ruibartsegura/ESP-Micro_drone/img/pcb_big.png

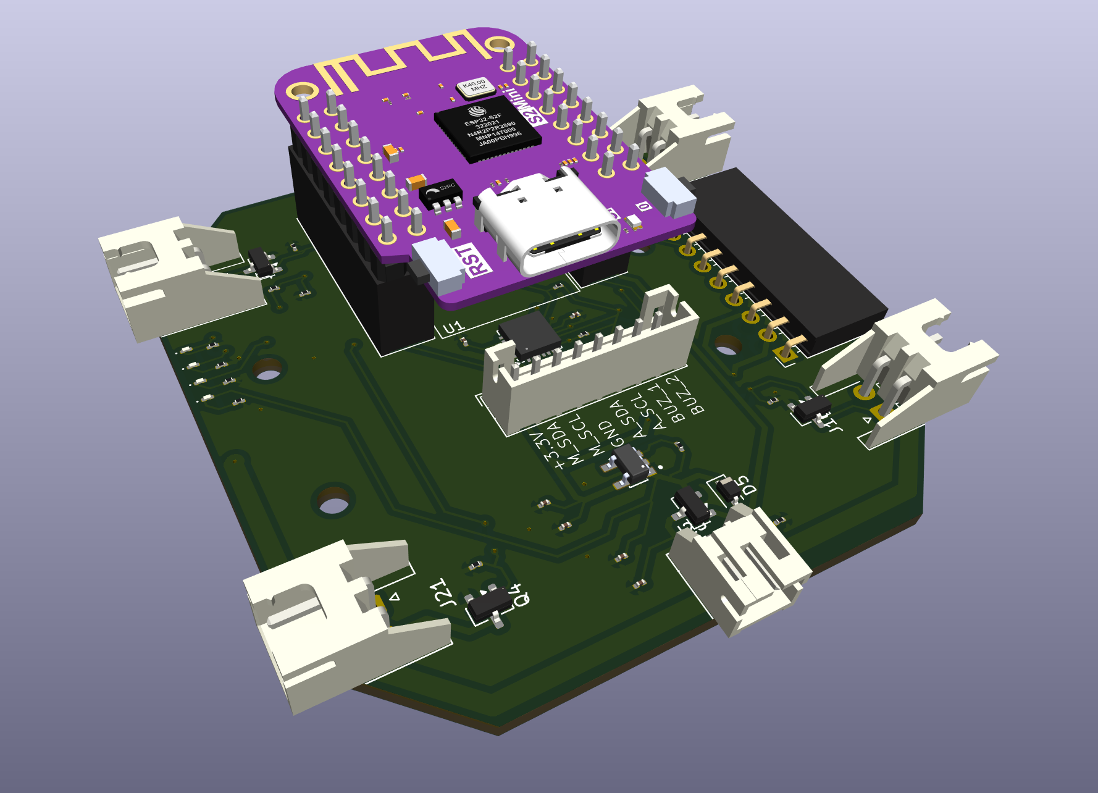
img/pcb_big.png
