ruibartsegura/ESP-Micro_drone/img/pcb_mini.png

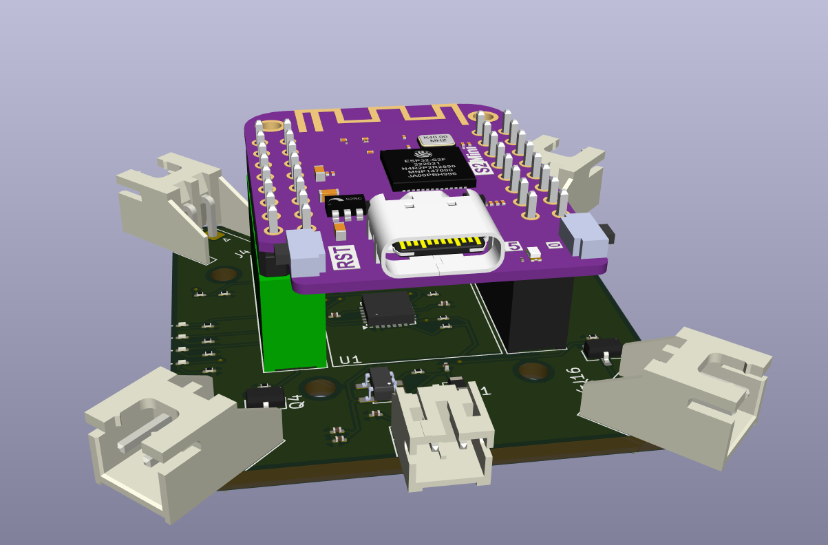
img/pcb_mini.png
