ruibartsegura/ESP-Micro_drone/img/pcb_smt.png

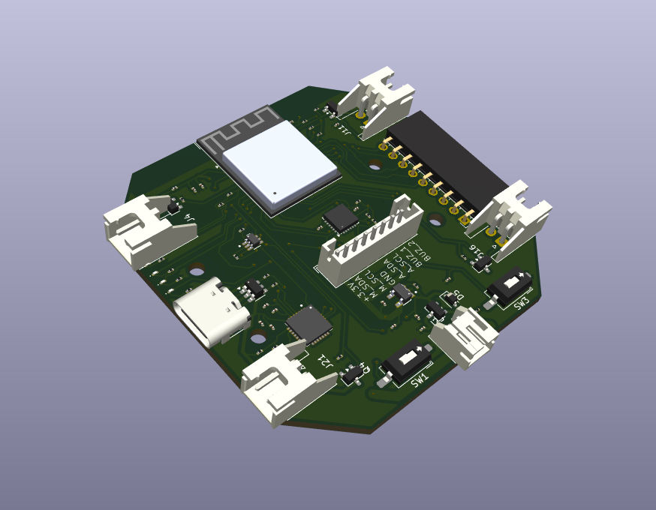
img/pcb_smt.png
