ruibartsegura/ESP-Micro_drone/Hardware_Design/Drone_Complete/motor_revol.FCStd

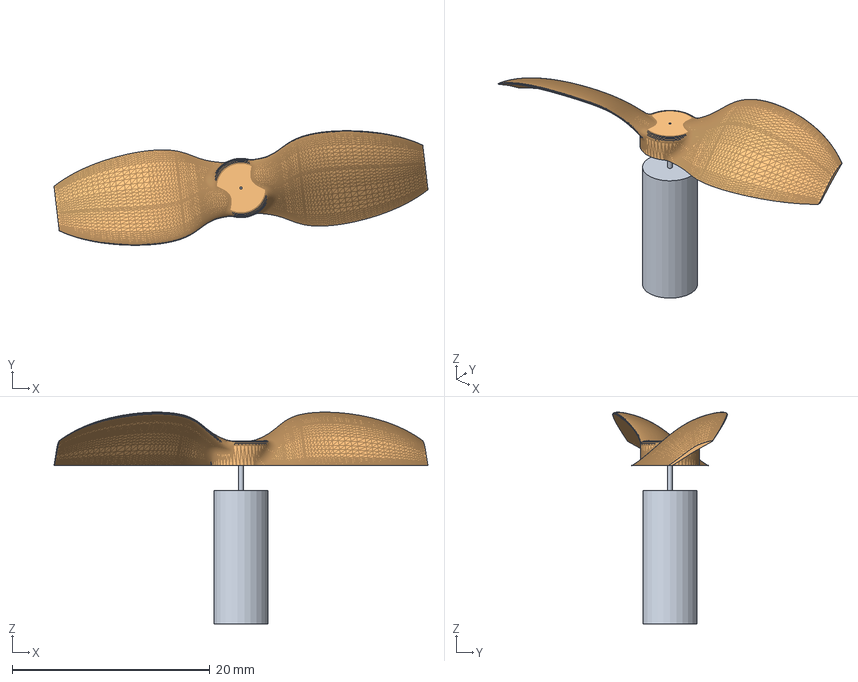
[picture p5: CAD file, 2026-03-26]
Hardware_Design/Drone_Complete/motor_revol.FCStd
37.8 x 11.6 x 21.4 mm
Scale
