ruibartsegura/ESP-Micro_drone/PCB_design/ESP_plug_mini_PCB_gy87/drone/production/drone.step

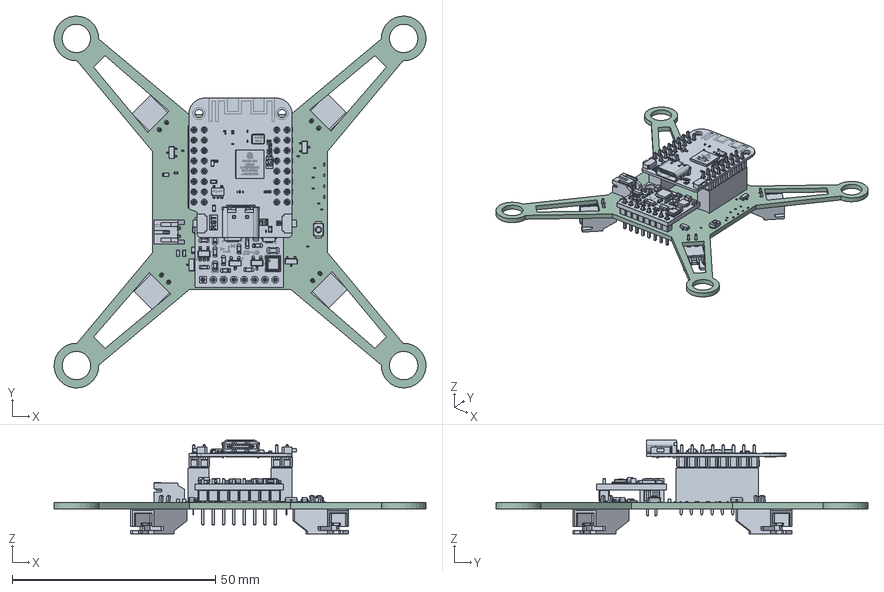
[picture p6: CAD file, 2026-09-25]
PCB_design/ESP_plug_mini_PCB_gy87/drone/production/drone.step
91.4 x 91.4 x 23.1 mm
C_0603_1608Metric x 9
LED_0201_0603Metric x 4
SOT-23 x 6
R_0201_0603Metric x 9
R_0402_1005Metric
SW_SPST_B3U-1000P
C_0201_0603Metric
USB_type_C_smd_12p v1
Pads
Pads2
Pads3
Pads4
Top Text
Bottom Text
Light
Anode Bottom
Cathode Bottom
Anode
Cathode
Base
40.00 MHz Oscillator v1
ESP32-S2 v3
ME6211-SOT23 v1
R01005 v2 x 6
uController Reset Button v1 x 2
pin x 32
D_SOD-323
R_0603_1608Metric x 8
JST_PH_S2B-PH-K_1x02_P2.00mm_Horizontal
PinSocket_2x08_P2.54mm_Vertical x 2
QFN-24-1EP_4x4mm_P0.5mm_EP2.7x2.7mm
SOT-23-5
LED_0603_1608Metric
BMP180
QFN-16-1EP_3x3mm_P0.5mm_EP1.7x1.7mm
CP_EIA-1608-10_AVX-L
C_0805_2012Metric x 4
PinHeader_1x08_P2.54mm_Vertical
GY87_10DOF_IMU_pad
GY87_10DOF_IMU_silkscreen
GY87_10DOF_IMU_soldermask
GY87_10DOF_IMU_PCB
JST_XH_S2B-XH-A-1_1x02_P2.50mm_Horizontal x 4
drone_PCB
