ruibartsegura/ESP-Micro_drone/Hardware_Design/Drone_Complete/pcb.FCStd

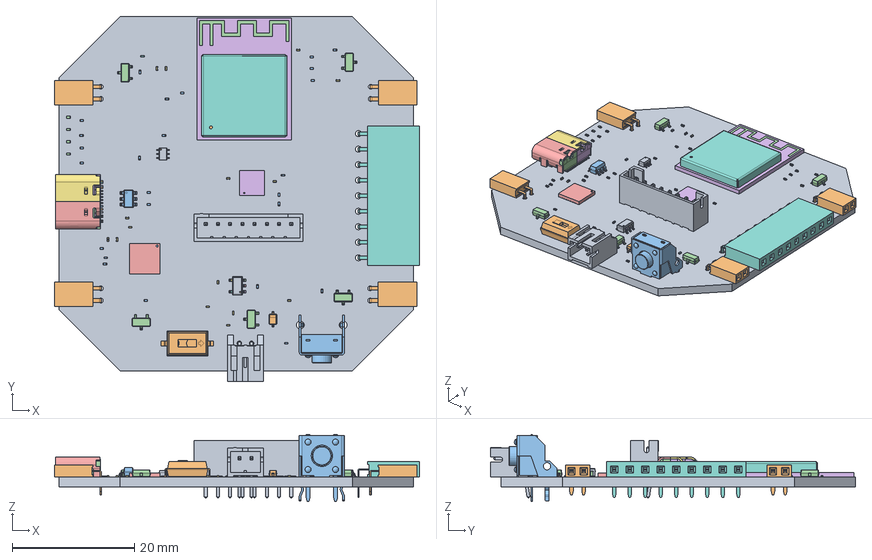
[picture p8: CAD file, 2026-03-26]
Hardware_Design/Drone_Complete/pcb.FCStd
59.8 x 59.8 x 11.0 mm
Pcb_9cbb
J21_PinSocket_1x02_P2.00mm_Horizontal_78d1e54ad34e x 4
R14_R_0201_0603Metric_42a1c245250d x 25
D7_LED_0201_0603Metric_9e26893dd0f0 x 4
CP2102N-A01-GQFN28
CP2102N-A01-GQFN029
CP2102N-A01-GQFN030
CP2102N-A01-GQFN031
CP2102N-A01-GQFN032
CP2102N-A01-GQFN033
CP2102N-A01-GQFN034
CP2102N-A01-GQFN035
CP2102N-A01-GQFN036
CP2102N-A01-GQFN037
CP2102N-A01-GQFN038
CP2102N-A01-GQFN039
CP2102N-A01-GQFN040
CP2102N-A01-GQFN041
CP2102N-A01-GQFN042
CP2102N-A01-GQFN043
CP2102N-A01-GQFN044
CP2102N-A01-GQFN045
CP2102N-A01-GQFN046
CP2102N-A01-GQFN047
CP2102N-A01-GQFN048
CP2102N-A01-GQFN049
CP2102N-A01-GQFN050
CP2102N-A01-GQFN051
CP2102N-A01-GQFN052
CP2102N-A01-GQFN053
CP2102N-A01-GQFN054
CP2102N-A01-GQFN055
CP2102N-A01-GQFN056
CP2102N-A01-GQFN057
CP2102N-A01-GQFN058
USB_C_Receptacle_16P_TopMnt_Horizontal_GCT_USB4105-xx-A
USB_C_Receptacle_16P_TopMnt_Horizontal_GCT_USB4105-xx-A001
USB_C_Receptacle_16P_TopMnt_Horizontal_GCT_USB4105-xx-A002
USB_C_Receptacle_16P_TopMnt_Horizontal_GCT_USB4105-xx-A003
USB_C_Receptacle_16P_TopMnt_Horizontal_GCT_USB4105-xx-A004
USB_C_Receptacle_16P_TopMnt_Horizontal_GCT_USB4105-xx-A005
USB_C_Receptacle_16P_TopMnt_Horizontal_GCT_USB4105-xx-A006
USB_C_Receptacle_16P_TopMnt_Horizontal_GCT_USB4105-xx-A007
USB_C_Receptacle_16P_TopMnt_Horizontal_GCT_USB4105-xx-A008
USB_C_Receptacle_16P_TopMnt_Horizontal_GCT_USB4105-xx-A009
USB_C_Receptacle_16P_TopMnt_Horizontal_GCT_USB4105-xx-A010
USB_C_Receptacle_16P_TopMnt_Horizontal_GCT_USB4105-xx-A011
USB_C_Receptacle_16P_TopMnt_Horizontal_GCT_USB4105-xx-A012
USB_C_Receptacle_16P_TopMnt_Horizontal_GCT_USB4105-xx-A013
USB_C_Receptacle_16P_TopMnt_Horizontal_GCT_USB4105-xx-A014
USB_C_Receptacle_16P_TopMnt_Horizontal_GCT_USB4105-xx-A015
USB_C_Receptacle_16P_TopMnt_Horizontal_GCT_USB4105-xx-A016
USB_C_Receptacle_16P_TopMnt_Horizontal_GCT_USB4105-xx-A017
USB_C_Receptacle_16P_TopMnt_Horizontal_GCT_USB4105-xx-A018
USB_C_Receptacle_16P_TopMnt_Horizontal_GCT_USB4105-xx-A019
USB_C_Receptacle_16P_TopMnt_Horizontal_GCT_USB4105-xx-A020
USB_C_Receptacle_16P_TopMnt_Horizontal_GCT_USB4105-xx-A021
USB_C_Receptacle_16P_TopMnt_Horizontal_GCT_USB4105-xx-A022
USB_C_Receptacle_16P_TopMnt_Horizontal_GCT_USB4105-xx-A023
USB_C_Receptacle_16P_TopMnt_Horizontal_GCT_USB4105-xx-A024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
