ruibartsegura/ESP-Micro_drone/PCB_design/extra_step_files/Wemos S2 Mini V1.0.0.step

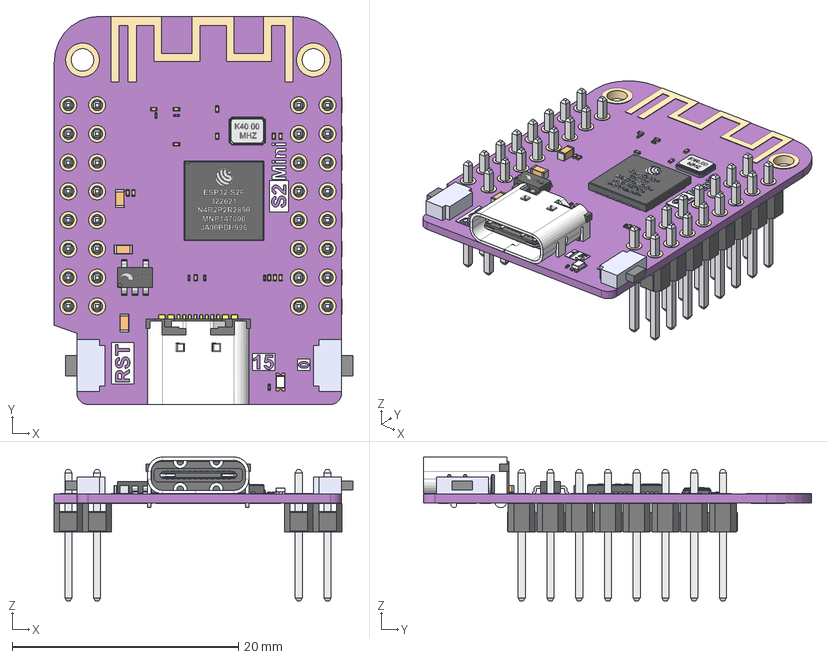
[picture p9: CAD file, 2026-09-25]
PCB_design/extra_step_files/Wemos S2 Mini V1.0.0.step
26.4 x 34.3 x 12.7 mm
USB_type_C_smd_12p
Pads
Pads2
Pads3
Pads4
Top Text
Bottom Text
Light
Anode Bottom
Cathode Bottom
Anode
Cathode
Base
40.00 MHz Oscillator
ESP32-S2
ME6211-SOT23
R01005 x 6
uController Reset Button x 2
pin x 32
