ruibartsegura/ESP-Micro_drone/Hardware_Design/Drone_Complete/motor_revol_esp.FCStd

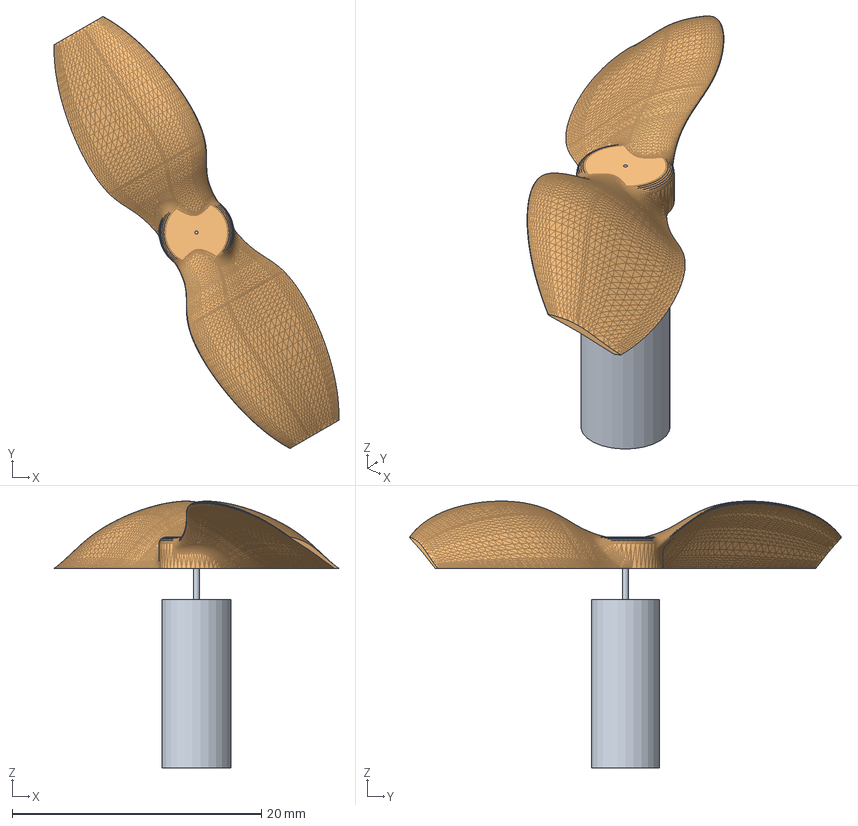
[picture p10: CAD file, 2026-03-26]
Hardware_Design/Drone_Complete/motor_revol_esp.FCStd
22.8 x 34.6 x 21.4 mm
Scale (reflejado)
