ruibartsegura/ESP-Micro_drone/Hardware_Design/Drone_Complete/Motor.FCStd

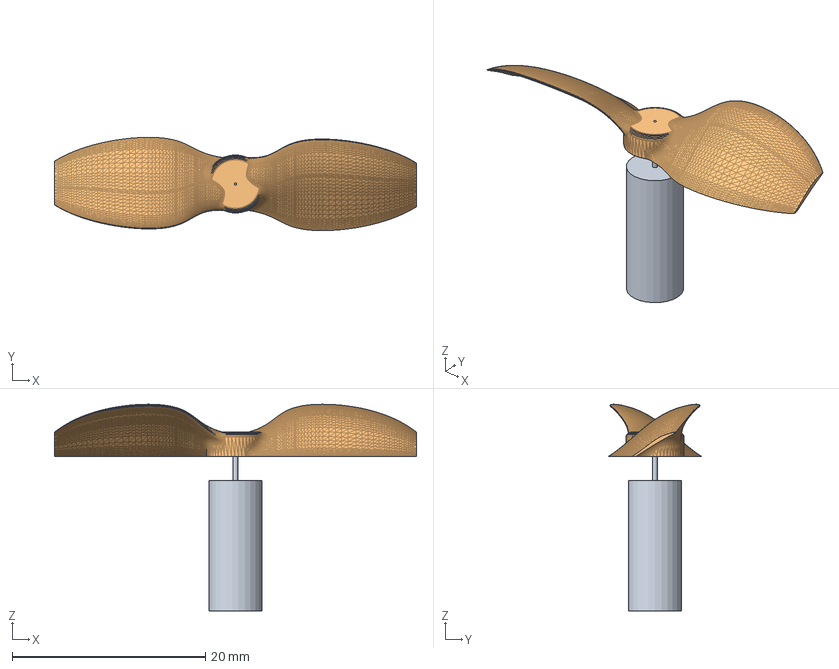
[picture p11: CAD file, 2026-03-26]
Hardware_Design/Drone_Complete/Motor.FCStd
37.5 x 9.66 x 21.4 mm
Scale
