ruibartsegura/ESP-Micro_drone/PCB_design/ESP_plug_mini_PCB_gy87/drone/drone.kicad_pcb

## KiCad design PCB_design/ESP_plug_mini_PCB_gy87/drone/drone.kicad_pcb (2026-09-25)

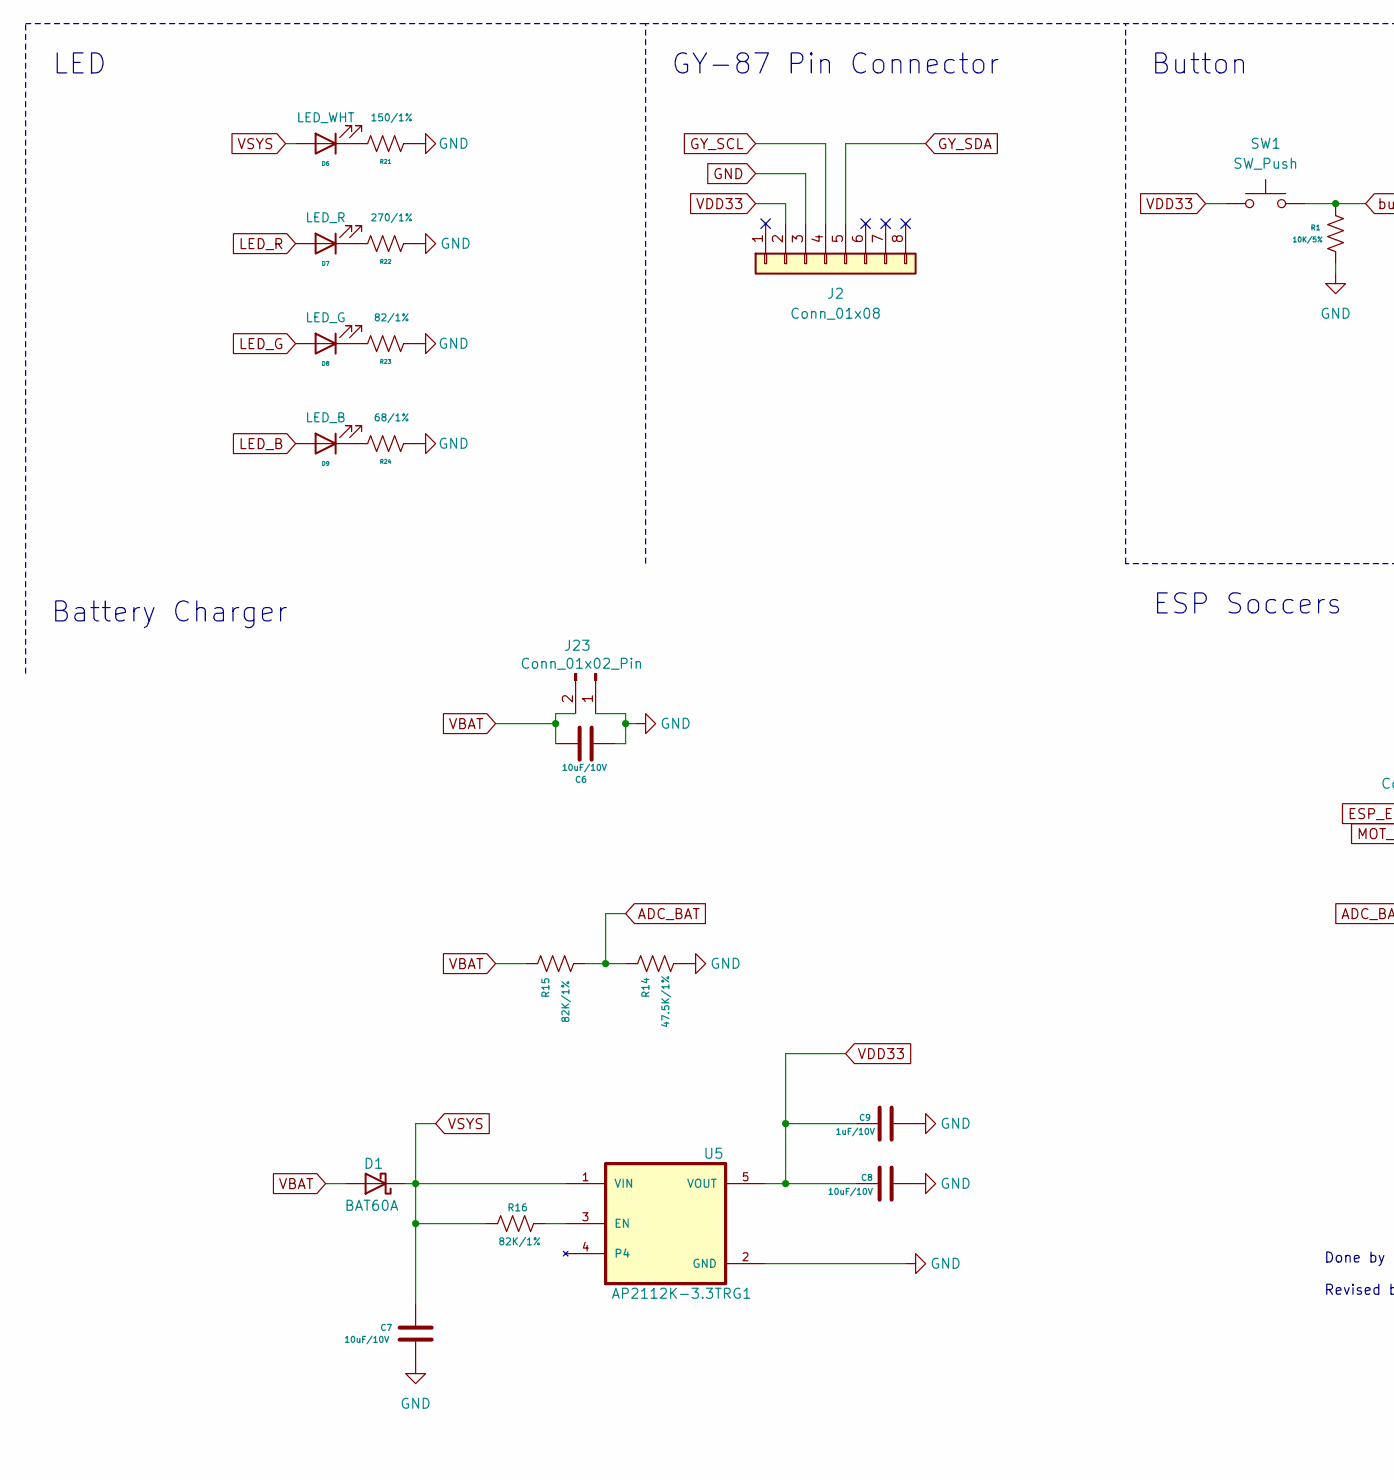
[picture p12: schematic drone.kicad_sch, part in row 1, column 1]

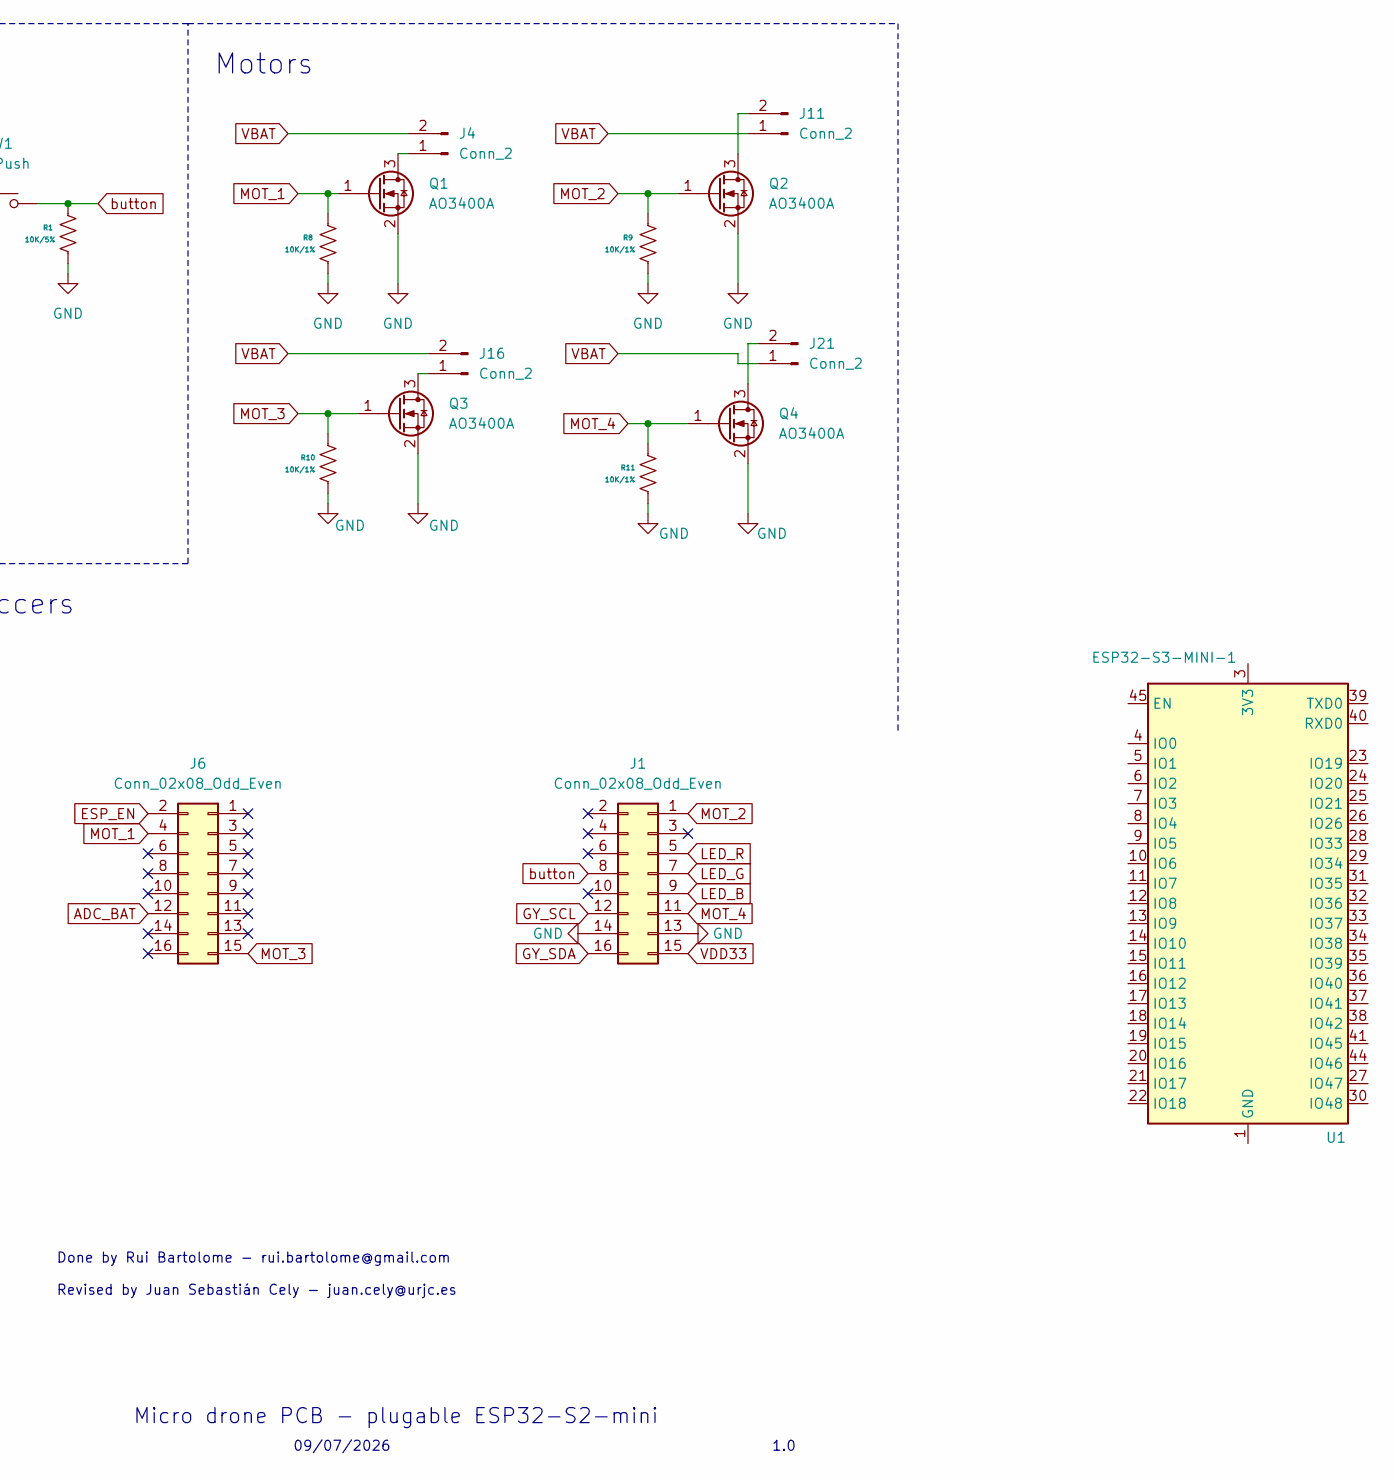
[picture p13: schematic drone.kicad_sch, part in row 1, column 2]

Parts:
C6, C7, C8: 10uF/10V; C_0603_1608Metric
C9: 1uF/10V; C_0201_0603Metric
D1: BAT60A; D_SOD-323
D6: LED_WHT; LED_0201_0603Metric
D7: LED_R; LED_0201_0603Metric
D8: LED_G; LED_0201_0603Metric
D9: LED_B; LED_0201_0603Metric
J1, J6: Conn_02x08_Odd_Even; PinSocket_2x08_P2.54mm_Vertical
J2: Conn_01x08; PinHeader_1x08_P2.54mm_Vertical
J4, J11, J16, J21: Conn_2; JST_XH_S2B-XH-A-1_1x02_P2.50mm_Horizontal
J23: Conn_01x02_Pin; JST_PH_S2B-PH-K_1x02_P2.00mm_Horizontal
Q1, Q2, Q3, Q4: AO3400A; SOT-23
R1: 10K/5%; R_0201_0603Metric
R8, R9, R10, R11: 10K/1%; R_0201_0603Metric
R14: 47.5K/1%; R_0402_1005Metric
R15, R16: 82K/1%; R_0603_1608Metric
R21: 150/1%; R_0201_0603Metric
R22: 270/1%; R_0201_0603Metric
R23: 82/1%; R_0201_0603Metric
R24: 68/1%; R_0201_0603Metric
SW1: SW_Push; SW_SPST_B3U-1000P
U1: ESP32-S3-MINI-1
U5: AP2112K-3.3TRG1; PARTREV 2-2

Connections:
ADC_BAT: J6.12, R14.2, R15.1
ESP_EN: J6.2
GND: C6.1, C7.1, C8.1, C9.1, J1.13, J1.14, J2.3, J23.1, Q1.2 (S), Q2.2 (S), Q3.2 (S), Q4.2 (S), R1.2, R8.2, R9.2, R10.2, R11.2, R14.1, R21.1, R22.1, R23.1, R24.1, U5.2 (GND)
GY_SCL: J1.12, J2.4
GY_SDA: J1.16, J2.5
LED_B: D9.2 (A), J1.9
LED_G: D8.2 (A), J1.7
LED_R: D7.2 (A), J1.5
MOT_1: J6.4, Q1.1 (G), R8.1
MOT_2: J1.1, Q2.1 (G), R9.1
MOT_3: J6.15, Q3.1 (G), R10.1
MOT_4: J1.11, Q4.1 (G), R11.1
unnamed: D6.1 (K), R21.2
unnamed: D7.1 (K), R22.2
unnamed: D8.1 (K), R23.2
unnamed: D9.1 (K), R24.2
unnamed: J4.1, Q1.3 (D)
unnamed: J11.2, Q2.3 (D)
unnamed: J16.1, Q3.3 (D)
unnamed: J21.2, Q4.3 (D)
unnamed: R16.2, U5.3 (EN)
VBAT: C6.2, D1.2 (A), J4.2, J11.1, J16.2, J21.1, J23.2, R15.2
VDD33: C8.2, C9.2, J1.15, J2.2, SW1.1, U5.5 (VOUT)
VSYS: C7.2, D1.1 (K), D6.2 (A), R16.1, U5.1 (VIN)
button: J1.8, R1.1, SW1.2

Notes on the sheet:
Button
Micro drone PCB - plugable ESP32-S2-mini
Battery Charger
GY-87 Pin Connector
Done by Rui Bartolome - rui.bartolome@gmail.com Revised by Juan Sebastián Cely - juan.cely@urjc.es
LED
1.0
09/07/2026
Motors
ESP Soccers

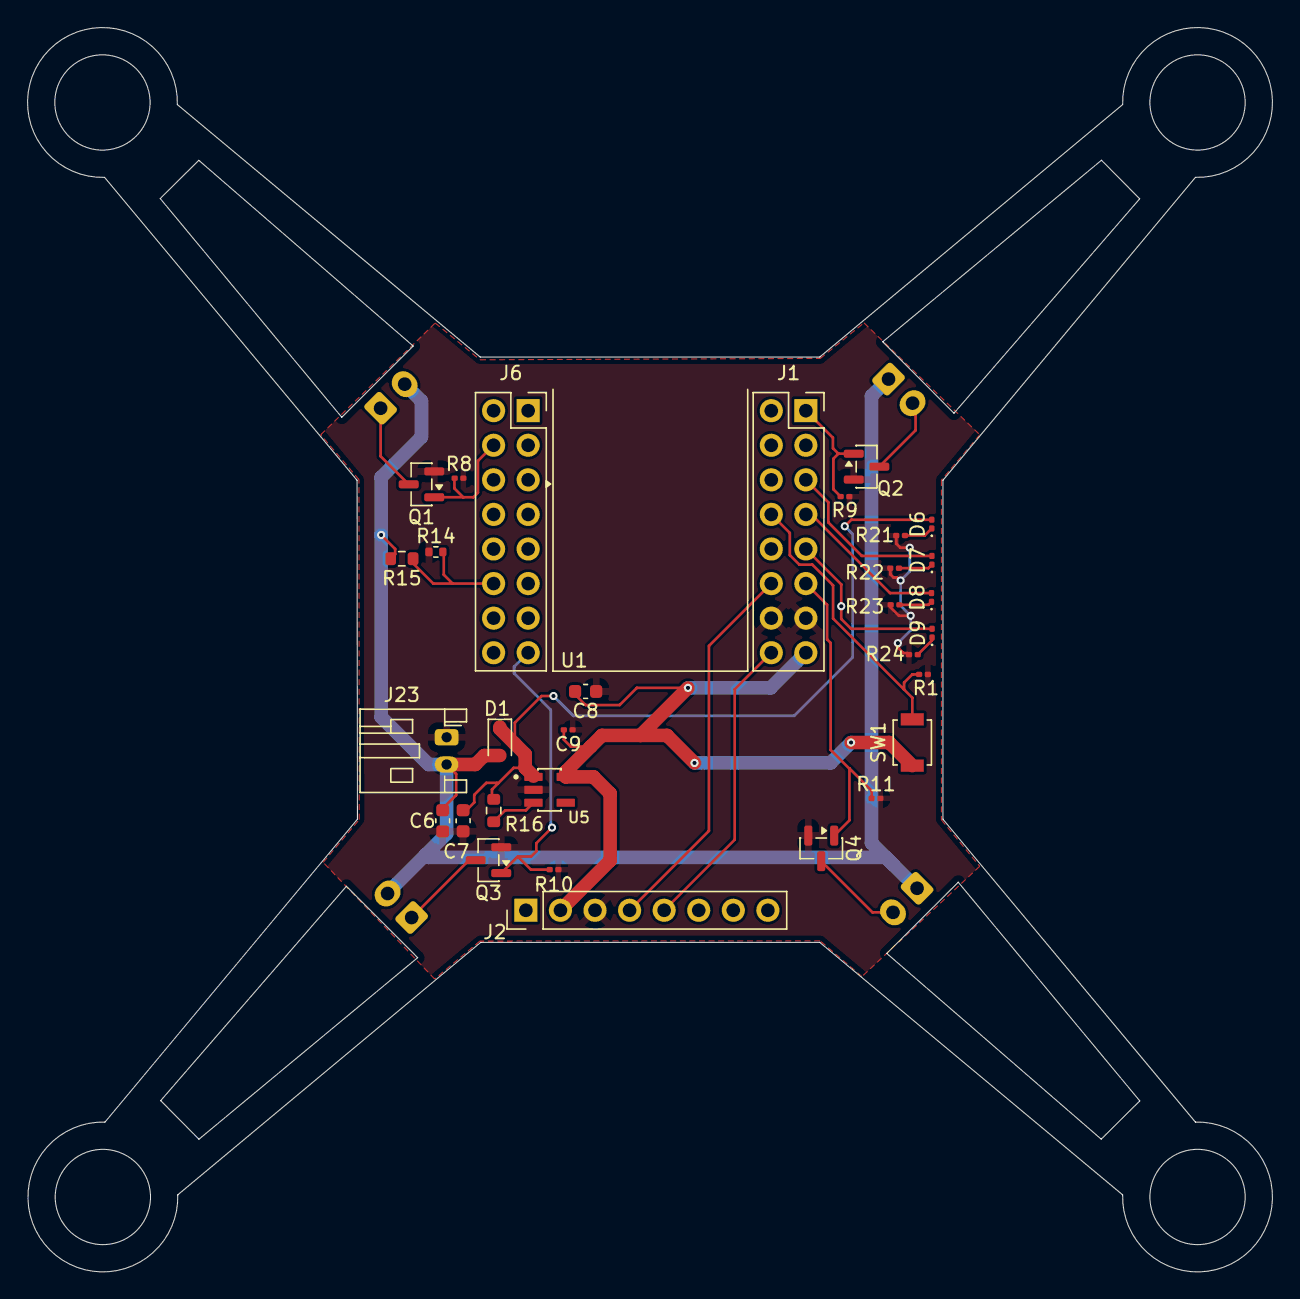
[picture p14: board drone.kicad_pcb from above]

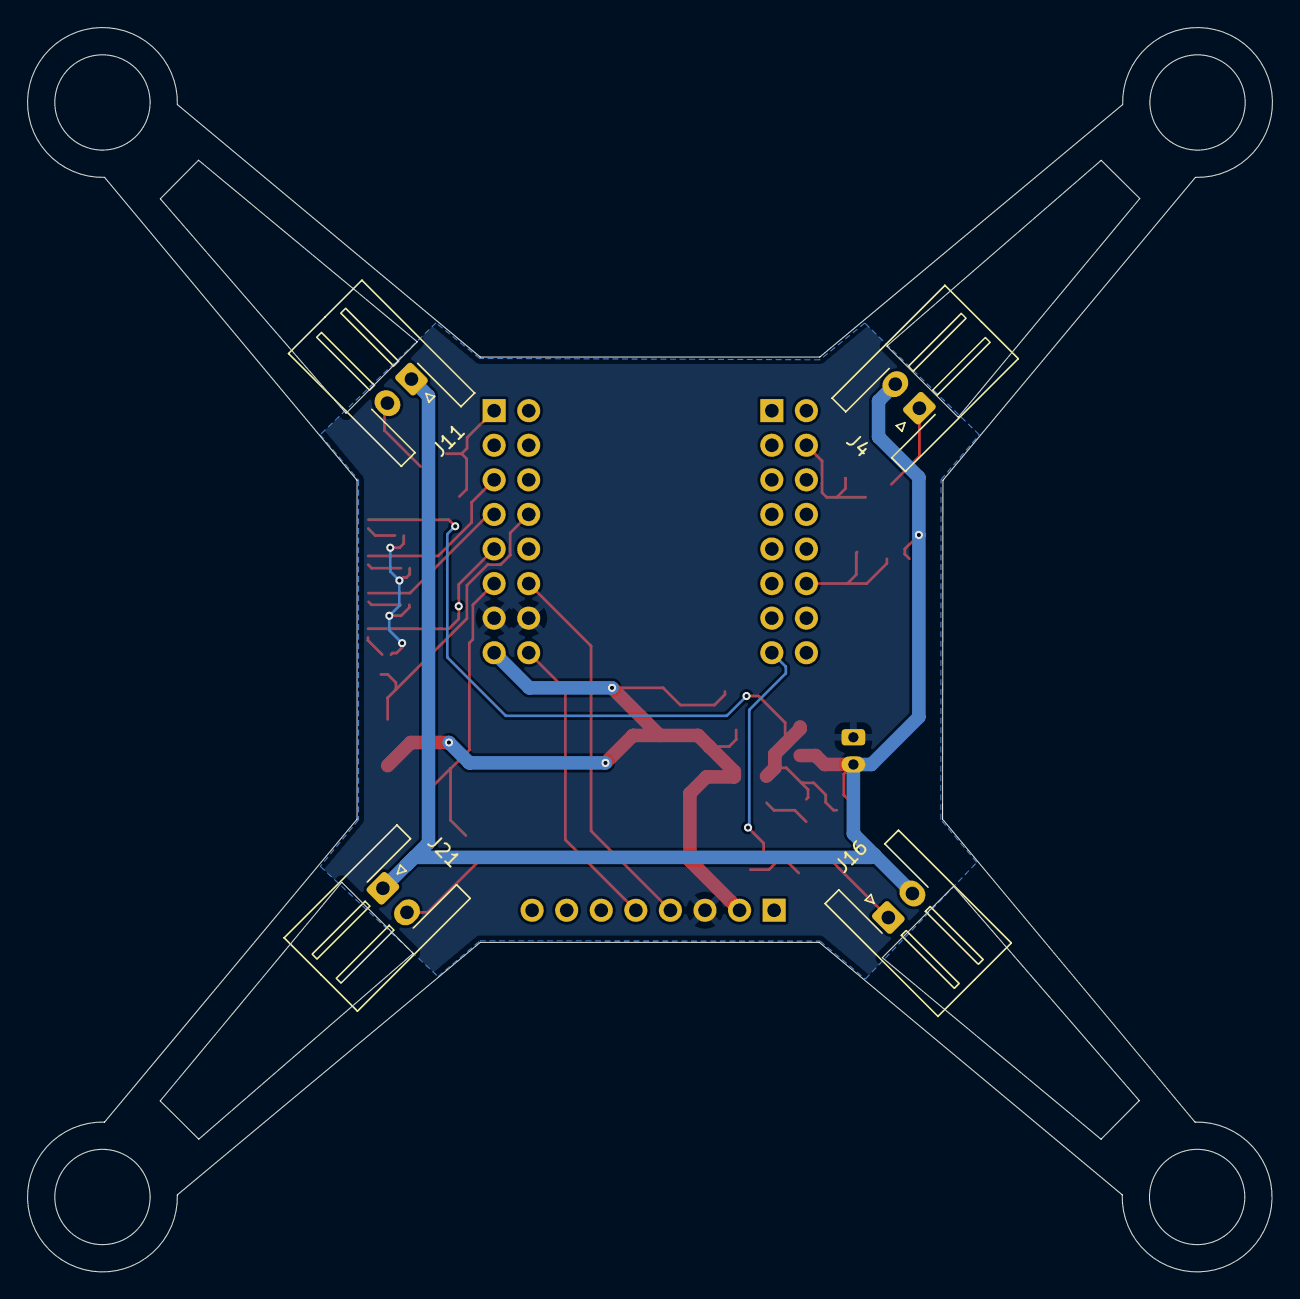
[picture p15: board drone.kicad_pcb from below]

Board: 2 copper layers, 91.5 x 91.4 mm, 36 parts (4 on the bottom side), 24 nets.
