ruibartsegura/ESP-Micro_drone/code/esp_code/components/system/system.c

/**
 * Made by Rui B.S.
 * Date: 22/07/2026
 * email: rui.bartolome@gmail.com
 *
 * Description:
 *   Core of the drone. It initialises every module (state, LEDs, sensors,
 *   motors, attitude controller and micro-ROS) and runs the state machine
 *   in its own FreeRTOS task every 20 ms:
 *   INIT -> CHECKING -> ARMING -> TAKING_OFF -> HOVERING <-> EXTERNAL_CONTROL
 *   -> LANDING -> DISARMING. ERROR is a final state.
 *   In simulation mode the IMU and barometer drivers are not started.
 *
 * Functions:
 *   - system_init(): initialises all the modules in order (micro-ROS last).
 *   - system_test(): checks that all the modules started correctly.
 *   - change_state(): changes the state machine state and saves it in the global state.
 *   - get_attitude(): returns the target attitude (cmd_vel + height).
 *   - check_takeOff_2_hov(): checks if the take-off height has been reached.
 *   - blink(): blinks a LED without stopping the state machine.
 *   - state_machine(): runs one step of the state machine.
 *   - system_task(): FreeRTOS task that calls state_machine() periodically.
 *   - system_start(): creates the system task.
 */

#include "system.h"

#include <stdbool.h>
#include <stdint.h>
#include <geometry_msgs/msg/twist.h>


// Free RTOS
#include "freertos/FreeRTOS.h"
#include "freertos/task.h"
#include "esp_log.h"
#include "esp_timer.h"

// Global_data
#include "state.h"
#include "cpu_stats.h"

// Drivers
#include "led.h"
#include "imu.h"
#include "height.h"
#include "motors.h"

#include "attitude_controller.h"
#include "odometry_estimator.h"
#include "tuning.h"

// Microros
#include "ros_coordinator.h"

#define SYSTEM_TASK_PERIOD_MS 20

// Expire time fot cmd vel msg
#define CMD_VEL_EXPIRE_TIME 500


static const char *TAG = "SYSTEM";

// Target of velocities + height
static ATTITUDE_TARGET att_target;

// Hover velocity = 0;
static geometry_msgs__msg__Twist hover_vel = {0};


static sm_states_t state = INIT;
static bool is_init = false;

void system_init(void) {
    if (is_init) {
        return;
    }

    state_init();
    init_cpu_stats(); // CPU / period log (only with CONFIG_CPU_STATS_ON)
    vTaskDelay(pdMS_TO_TICKS(500));

    led_init();
    vTaskDelay(pdMS_TO_TICKS(500));

    #ifndef CONFIG_SIMULATION_ON
        imu_init();
        vTaskDelay(pdMS_TO_TICKS(500));

        height_init();
        vTaskDelay(pdMS_TO_TICKS(500));
    #endif

    init_motors();
    vTaskDelay(pdMS_TO_TICKS(500));

    init_attitude_controller();
    vTaskDelay(pdMS_TO_TICKS(500));

    init_odom_estimator();
    vTaskDelay(pdMS_TO_TICKS(500));

    #ifdef CONFIG_GAINS_TUNE_ON
        init_tuning(); // change the gains from the serial console
    #endif

    ros_init(); // last init
    vTaskDelay(pdMS_TO_TICKS(1000));

    is_init = true;
}

bool system_test(void) {
    bool test = is_init;

    test &= led_test();

    #ifndef CONFIG_SIMULATION_ON
        test &= imu_test();
        test &= height_test();
    #endif

    //test &= motors_test();

    test &= ros_test();

    // ESP_LOGI(TAG, "Fin test result %d", test);
    return test;
}


// Change the state-machine state
void change_state(sm_states_t new_state) {
    state = new_state;
    set_sm_state(state);
}

// Return the desired attitude for the drone
ATTITUDE_TARGET get_attitude() {
    return att_target;
}


// Aux var
static bool blink_led = true;

// The LEDs blink by time: a vTaskDelay() here would stop the state machine
// (before it went at ~6 Hz while taking off, landing or in external control)
#define BLINK_PERIOD_MS 150
static int64_t t_blink_us = -1; // Time of the last change of the LED (-1 = never)

static void blink(led_t led) {
    int64_t now = esp_timer_get_time();
    if (t_blink_us >= 0 && now - t_blink_us < BLINK_PERIOD_MS * 1000LL) {
        return;
    }
    t_blink_us = now;

    if (blink_led) {
        led_on(led);
    } else {
        led_off(led);
    }
    blink_led = !blink_led;
}

void state_machine(void) {
    geometry_msgs__msg__Twist v; // For cmd_vel

    switch (state) {
        case INIT:
            system_init();

            change_state(CHECKING);

            break;

        case CHECKING:
            // While this state the params can be updated
            if (system_test()) {
                change_state(ARMING);
                led_on(LED_GREEN);
            } else {
                change_state(ERROR);
            }
            break;

        case ARMING:
            if (get_take_off_ready()) {
                arm_motors();

                reset_h_reached();

                change_state(TAKING_OFF);
            }
            break;

        case TAKING_OFF:
            att_target.cmd_vel = hover_vel;
            att_target.h = get_take_off_alt();

            if (check_h_reached()) {
                led_on(LED_BLUE);

                reset_h_reached();

                change_state(HOVERING);
            } else {
                blink(LED_BLUE);
            }
            break;

        case HOVERING:
            att_target.cmd_vel = hover_vel;
            att_target.h = get_take_off_alt();


            if (get_cmd_vel(&v, CMD_VEL_EXPIRE_TIME)) {
                change_state(EXTERNAL_CONTROL);
            }

            if (get_landing_ready()) {
                led_on(LED_GREEN);
                led_off(LED_BLUE);

                reset_h_reached();

                change_state(LANDING);
            }
            break;

        case EXTERNAL_CONTROL:
            if (get_cmd_vel(&v, 500)) {
                att_target.cmd_vel = v;
                att_target.h = get_take_off_alt();
            } else {
                att_target.cmd_vel = hover_vel;
                led_on(LED_BLUE);
                led_on(LED_GREEN);
                change_state(HOVERING);
            }

            if (get_landing_ready()) {
                led_on(LED_GREEN);
                led_off(LED_BLUE);

                reset_h_reached();

                change_state(LANDING);
            } else {
                blink(LED_GREEN);
            }
            break;

        case LANDING:
            att_target.cmd_vel = hover_vel;
            att_target.h = 0;

            if (check_h_reached()) {
                led_on(LED_RED);
                led_on(LED_GREEN);
                led_on(LED_BLUE);

                reset_h_reached();

                change_state(DISARMING);
            } else {
                blink(LED_RED);
            }
            break;

        case DISARMING:
            disarm_motors();
            motors_stop_all();

            led_on(LED_GREEN);
            led_off(LED_RED);
            led_off(LED_BLUE);

            change_state(ARMING);

            break;

        case ERROR:
            break;

    }
}


static void system_task(void *arg) {
    (void)arg;
    // int log_counter = 0;

    static task_period_t period = TASK_PERIOD("system_task", SYSTEM_TASK_PERIOD_MS);
    TickType_t t_wake = xTaskGetTickCount();

    while (1) {
        task_period_tick(&period); // CPU / period log (CONFIG_CPU_STATS_ON)
        state_machine();

        // if (++log_counter >= 250) {
            // log_counter = 0;
            // UBaseType_t free_words = uxTaskGetStackHighWaterMark(NULL);
            // ESP_LOGI("system_task", "stack libre (min historico): %u bytes",
                     // (unsigned)(free_words * sizeof(StackType_t)));
        // }

        // Fixed period (vTaskDelay would add the time of the work). If the
        // task was late, count again from now instead of running to catch up
        if (xTaskDelayUntil(&t_wake, pdMS_TO_TICKS(SYSTEM_TASK_PERIOD_MS)) == pdFALSE) {
            t_wake = xTaskGetTickCount();
        }
    }
}

void system_start(void) {
    xTaskCreate(system_task,
        "system_task",
        CONFIG_SYSTEM_TASK_STACK,
        NULL,
        CONFIG_SYSTEM_TASK_PRIO,
        NULL);
}

// TODO
//      Implementar params en configuration,
//      hacer get/set para modificarlo con ros_coordinator
