ruibartsegura/ESP-Micro_drone/code/esp_code/components/flight_control/quaternions.c

/**
 * Made by Rui B.S.
 * Date: 22/07/2026
 * email: rui.bartolome@gmail.com
 * Based on: "MPU6050 ESP32 Sensor Interface", original author Muhammad Idrees
 *
 * Description:
 *   Madgwick filter with quaternions to estimate the orientation of the
 *   drone from the gyroscope and the accelerometer.
 *
 * Functions:
 *   - inv_sqrt(): returns 1/sqrt(x).
 *   - wrap_angle(): keeps an angle inside [-pi, pi].
 *   - quaternion_init(): sets the identity quat_t.
 *   - quaternion_update(): runs one step of the Madgwick filter.
 *   - quaternion_get_roll() / _pitch() / _yaw(): return the Euler angles.
 */

#include "quaternions.h"
#include <math.h>

#define BETA 0.08f

static float inv_sqrt(float x) {
    if (x <= 0.0f) {
        return 0.0f; // evita div/0 o NaN si llega un vector nulo
    }
    return 1.0f / sqrtf(x);
}

static float wrap_angle(float angle) {
    if (angle > 180.0f) {
        return angle - 360.0f;
    } else if (angle < -180.0f) {
        return angle + 360.0f;
    }
    return angle;
}

void quaternion_init(quat_t *q) {
    q->w = 1.0f;
    q->x = 0.0f;
    q->y = 0.0f;
    q->z = 0.0f;
}

void quaternion_update(quat_t *q, float gx, float gy, float gz,
                        float ax, float ay, float az, float dt) {
    float accel_norm_sq = ax * ax + ay * ay + az * az;

    float q_dot1 = 0.5f * (-q->x * gx - q->y * gy - q->z * gz);
    float q_dot2 = 0.5f * (q->w * gx + q->y * gz - q->z * gy);
    float q_dot3 = 0.5f * (q->w * gy - q->x * gz + q->z * gx);
    float q_dot4 = 0.5f * (q->w * gz + q->x * gy - q->y * gx);

    // Solo aplicamos la corrección del acelerómetro si la lectura es
    // válida (evita 0/0 al normalizar).
    if (accel_norm_sq > 1.0e-6f) {
        float accel_inv_norm = inv_sqrt(accel_norm_sq);
        float ax_n = ax * accel_inv_norm;
        float ay_n = ay * accel_inv_norm;
        float az_n = az * accel_inv_norm;

        float f1 = 2.0f * (q->x * q->z - q->w * q->y) - ax_n;
        float f2 = 2.0f * (q->w * q->x + q->y * q->z) - ay_n;
        float f3 = 2.0f * (0.5f - q->x * q->x - q->y * q->y) - az_n;

        float j11 = -2.0f * q->y;
        float j12 = 2.0f * q->z;
        float j13 = -2.0f * q->w;
        float j14 = 2.0f * q->x;
        float j21 = 2.0f * q->x;
        float j22 = 2.0f * q->w;
        float j23 = 2.0f * q->z;
        float j24 = 2.0f * q->y;
        float j32 = -4.0f * q->x;
        float j33 = -4.0f * q->y;

        float step1 = j11 * f1 + j21 * f2;
        float step2 = j12 * f1 + j22 * f2 + j32 * f3;
        float step3 = j13 * f1 + j23 * f2 + j33 * f3;
        float step4 = j14 * f1 + j24 * f2;

        float step_norm_sq = step1 * step1 + step2 * step2 +
                              step3 * step3 + step4 * step4;
        float step_inv_norm = inv_sqrt(step_norm_sq);
        step1 *= step_inv_norm;
        step2 *= step_inv_norm;
        step3 *= step_inv_norm;
        step4 *= step_inv_norm;

        q_dot1 -= BETA * step1;
        q_dot2 -= BETA * step2;
        q_dot3 -= BETA * step3;
        q_dot4 -= BETA * step4;
    }

    q->w += q_dot1 * dt;
    q->x += q_dot2 * dt;
    q->y += q_dot3 * dt;
    q->z += q_dot4 * dt;

    float q_norm_sq = q->w * q->w + q->x * q->x + q->y * q->y + q->z * q->z;
    float q_inv_norm = inv_sqrt(q_norm_sq);
    q->w *= q_inv_norm;
    q->x *= q_inv_norm;
    q->y *= q_inv_norm;
    q->z *= q_inv_norm;
}

float quaternion_get_roll(const quat_t *q) {
    float roll = atan2f(2.0f * (q->w * q->x + q->y * q->z),
                        1.0f - 2.0f * (q->x * q->x + q->y * q->y)) * 180.0f / (float)M_PI;
    return wrap_angle(roll);
}

float quaternion_get_pitch(const quat_t *q) {
    float sinp = 2.0f * (q->w * q->y - q->z * q->x);

    if (fabsf(sinp) >= 1.0f) {
        sinp = copysignf(1.0f, sinp);
    }

    float pitch_deg = asinf(sinp) * 180.0f / (float)M_PI;
    return wrap_angle(pitch_deg);
}

float quaternion_get_yaw(const quat_t *q) {
    float yaw = atan2f(2.0 * (q->w * q->z + q->x * q->y),
                       1.0 - 2.0 * (q->y * q->y + q->z * q->z)) * 180.0f / (float)M_PI;
    return wrap_angle(yaw);
}
