ruibartsegura/ESP-Micro_drone/code/esp_code/host_test/test_attitude_controller.c

/**
 * Made by Rui B.S.
 * Date: 08/10/2026
 * email: rui.bartolome@gmail.com
 *
 * Description:
 *   Unit tests for attitude_controller.c (host, no hardware). They replace
 *   the old tests of components/flight_control/test, that used the old API
 *   (get_imu_data(), set_motor_speed(id, speed)). They cover:
 *     1. Complementary filter.
 *     2. Attitude estimation: get_roll_pitch() (gyro + accelerometer).
 *     3. Outer loop: cmd_vel_2_RP() (velocity loop: velocity error ->
 *        target roll / pitch, ENU: +pitch to +x, +roll to -y).
 *     4. Inner loop: angular rate -> motor mix (roll / pitch / yaw).
 *     5. Height: collective thrust, check_h_reached() and reset_h_reached().
 *     6. Height estimation: get_h() (accelerometer + barometer) and
 *        get_vel_z().
 *     7. Gains: get_gains() / set_gains().
 *     8. Task and init.
 *     9. Integral of the roll / pitch rate and gain of the yaw.
 *
 *   setUp() leaves the state machine in INIT (not flying), so the integral
 *   is 0 and sections 4-7 check the P part alone. Section 9 flies.
 *
 *   The real state.c is linked (the controller reads the IMU and the
 *   height from the global state). get_attitude() (system.c) and
 *   set_motor_speed() (motors.c) are mocked.
 *
 *   Units (same as the drivers): acceleration in g (Z = +1 g at rest),
 *   angular velocity in deg/s, time in ns, angles of the estimator in
 *   degrees, output of cmd_vel_2_RP() in radians, cmd_vel in m/s and rad/s,
 *   height in m.
 *
 *   Motor mix (X frame), with the commands h, r, p, y:
 *     m0 = h + r - p - y      m1 = h - r - p + y
 *     m2 = h + r + p + y      m3 = h - r + p - y
 *   decompose() is the exact inverse of this mix.
 *
 *   The .c file is included directly, so the tests can see its macros
 *   (KP, MAX_ANGLE, ...), functions and globals. Another version can be
 *   tested with:
 *       make run T=attitude_controller MODULE_SRC=path/to/attitude_controller.c
 *
 *   Tests that fail with the current code have [BUG] in their comment.
 *
 * Functions:
 *   - get_attitude(), set_motor_speed(): mocks of system.c and motors.c.
 *   - decompose(): splits the 4 motor values into h, r, p, y.
 *   - set_tilt(), set_baro(), step(), settle(): helpers to prepare the IMU
 *     and the barometer and run the controller.
 *   - setUp() / tearDown(): reset the mocks, the controller and the state.
 *   - test_comp_*, test_est_*, test_ext_*, test_int_*, test_h_*, test_hest_*,
 *     test_gains_*, test_task_*, test_i_*.
 *   - main(): runs all the tests.
 */
#include "unity.h"
#include "test_helpers.h"
#include "mocks/mock_reset.h"

#ifndef MODULE_SRC
#define MODULE_SRC "../components/flight_control/attitude_controller.c"
#endif
#include MODULE_SRC

/* Save the gravity and remove the one letter macro g. */
static const float K_G = g;
#undef g

/* ------------------------------------------------------------------ */
/*                               MOCKS                                */
/* ------------------------------------------------------------------ */
static ATTITUDE_TARGET mock_target;
static double          motors[N_MOTORS];
static int             motor_calls;

ATTITUDE_TARGET get_attitude() { return mock_target; }

void set_motor_speed(double power[N_MOTORS]) {
    memcpy(motors, power, sizeof motors);
    motor_calls++;
}

/* ------------------------------------------------------------------ */
/*                              HELPERS                               */
/* ------------------------------------------------------------------ */
#define DT_NS 15000000LL   /* 15 ms, period of the task */
#define BASE  ((double)THROTTLE_BASE)

typedef struct { double h, r, p, y; } Mix;

static Mix decompose(void) {
    Mix c;
    c.h = ( motors[0] + motors[1] + motors[2] + motors[3]) / 4.0;
    c.r = ( motors[0] - motors[1] + motors[2] - motors[3]) / 4.0;
    c.p = (-motors[0] - motors[1] + motors[2] + motors[3]) / 4.0;
    c.y = (-motors[0] + motors[1] + motors[2] - motors[3]) / 4.0;
    return c;
}

static int64_t t_now;
static float   baro;   /* height of the fake barometer (m) */

/* The barometer task writes the height in the state every 10 ms, faster
 * than the controller (15 ms), so step() writes it again before each cycle. */
static void set_baro(float h) {
    baro = h;
    set_h(h);
}

/* Accelerometer (in g) of a drone with this roll and pitch (degrees). */
static void set_tilt(float roll_deg, float pitch_deg) {
    set_acc_lin(-sinf(RAD(pitch_deg)),
                cosf(RAD(pitch_deg)) * sinf(RAD(roll_deg)),
                cosf(RAD(pitch_deg)) * cosf(RAD(roll_deg)));
}

/* One control cycle 15 ms later (IMU time and esp_timer). */
static void step(void) {
    t_now += DT_NS;
    mock_time_us += DT_NS / 1000;
    set_time_imu(t_now);
    set_h(baro);
    control_attitude();
}

/* n control cycles: lets the height filter converge to the barometer. */
#define SETTLE_STEPS 600   /* 9 s */
static void settle(void) {
    for (int i = 0; i < SETTLE_STEPS; i++) step();
}

/* One control cycle with the same IMU timestamp: dt = 0, no gyro integration. */
static void step_same_time(void) {
    set_time_imu(last_rpy.t_stamp);
    set_h(baro);
    control_attitude();
}

static GAINS default_gains;
static bool  default_gains_saved = false;

void setUp(void) {
    mock_reset_all();
    state_init();
    memset(&mock_target, 0, sizeof mock_target);
    memset(motors, 0, sizeof motors);
    motor_calls = 0;
    memset(&last_rpy, 0, sizeof last_rpy);
    err_h = 0.0f;
    h_reached = false;
    is_init = false;
    t_h_reached_us = -1;
    baro = 0.0f;
    mock_time_us = 1000000;  /* 1 s */
    /* Default gains (a test can change them with set_gains()) */
    if (!default_gains_saved) {
        get_gains(&default_gains);
        default_gains_saved = true;
    }
    set_gains(&default_gains);
    t_now = 1000000000LL;   /* 1 s */
    /* Height filter already started, with the ground at 0 m */
    h_init = true;
    h0 = 0.0f;
    h_est = 0.0f;
    last_vel_z = 0.0f;
    last_t_h = t_now;
    last_rpy.t_stamp = t_now;
    set_time_imu(t_now);
    set_tilt(0, 0);         /* level, +1 g on Z */
    i_roll = 0.0f;
    i_pitch = 0.0f;
    last_t_ctrl = t_now;
}

void tearDown(void) {}

/* ------------------------------------------------------------------ */
/*                       1. COMPLEMENTARY FILTER                      */
/* ------------------------------------------------------------------ */
void test_comp_alpha_1_returns_the_first(void) {
    TEST_ASSERT_FLOAT_WITHIN(1e-6f, 3.0f, complementary_filter(3.0f, 7.0f, 1.0f));
}

void test_comp_alpha_0_returns_the_second(void) {
    TEST_ASSERT_FLOAT_WITHIN(1e-6f, 7.0f, complementary_filter(3.0f, 7.0f, 0.0f));
}

void test_comp_blend_value(void) {
    TEST_ASSERT_FLOAT_WITHIN(1e-5f, 0.98f * 10.0f + 0.02f * 20.0f,
                             complementary_filter(10.0f, 20.0f, 0.98f));
}

void test_comp_alpha_trusts_the_gyro(void) {
    float a = alpha_of(ATTITUDE_TASK_PERIOD_MS / 1000.0f);
    TEST_ASSERT_TRUE(a > 0.9f && a < 1.0f);
}

/* TAU_RP keeps the old filter: ALPHA = 0.98 at 15 ms. */
void test_comp_alpha_at_15_ms_is_the_old_0_98(void) {
    TEST_ASSERT_FLOAT_WITHIN(1e-3f, 0.98f, alpha_of(0.015f));
}

/* dt = 0 is the same IMU sample again: nothing new, no correction. */
void test_comp_alpha_of_0_is_1(void) {
    TEST_ASSERT_FLOAT_WITHIN(1e-6f, 1.0f, alpha_of(0.0f));
}

/* With alpha_of(dt) the accelerometer corrects at the same speed at any
 * frequency: 0.5 s at 200 Hz and at 66 Hz give (almost) the same angle. */
void test_comp_correction_does_not_depend_on_the_frequency(void) {
    float r_fast = 0, r_slow = 0, p;
    set_tilt(20.0f, 0.0f);
    for (int i = 0; i < 100; i++) {          /* 100 x 5 ms */
        t_now += 5000000LL;
        set_time_imu(t_now);
        get_roll_pitch(&r_fast, &p);
    }
    memset(&last_rpy, 0, sizeof last_rpy);
    last_rpy.t_stamp = t_now;
    for (int i = 0; i < 33; i++) {           /* 33 x 15 ms */
        t_now += 15000000LL;
        set_time_imu(t_now);
        get_roll_pitch(&r_slow, &p);
    }
    TEST_ASSERT_FLOAT_WITHIN(0.3f, r_slow, r_fast);
    TEST_ASSERT_FLOAT_WITHIN(1.0f, 20.0f * (1.0f - expf(-0.5f / TAU_RP)), r_fast);
}

/* ------------------------------------------------------------------ */
/*                       2. ATTITUDE ESTIMATION                       */
/* ------------------------------------------------------------------ */
void test_est_level_and_still_is_zero(void) {
    float r, p;
    t_now += DT_NS; set_time_imu(t_now);
    get_roll_pitch(&r, &p);
    TEST_ASSERT_FLOAT_WITHIN(1e-5f, 0.0f, r);
    TEST_ASSERT_FLOAT_WITHIN(1e-5f, 0.0f, p);
}

void test_est_accel_converges_to_the_roll(void) {
    float r = 0, p = 0;
    set_tilt(20.0f, 0.0f);
    for (int i = 0; i < 500; i++) { t_now += DT_NS; set_time_imu(t_now); get_roll_pitch(&r, &p); }
    TEST_ASSERT_FLOAT_WITHIN(0.1f, 20.0f, r);
    TEST_ASSERT_FLOAT_WITHIN(0.1f, 0.0f, p);
}

void test_est_accel_converges_to_the_pitch(void) {
    float r = 0, p = 0;
    set_tilt(0.0f, -15.0f);
    for (int i = 0; i < 500; i++) { t_now += DT_NS; set_time_imu(t_now); get_roll_pitch(&r, &p); }
    TEST_ASSERT_FLOAT_WITHIN(0.1f, -15.0f, p);
    TEST_ASSERT_FLOAT_WITHIN(0.1f, 0.0f, r);
}

void test_est_one_step_of_the_accel_is_2_percent(void) {
    float r, p;
    set_tilt(10.0f, 0.0f);
    t_now += DT_NS; set_time_imu(t_now);
    get_roll_pitch(&r, &p);
    TEST_ASSERT_FLOAT_WITHIN(1e-3f, (1.0f - alpha_of(DT_NS / 1e9f)) * 10.0f, r);
}

void test_est_gyro_is_integrated_with_the_timestamps(void) {
    float r, p;
    set_vel_ang(10.0f, -20.0f, 0.0f);   /* deg/s */
    t_now += 10000000LL;                /* 10 ms */
    set_time_imu(t_now);
    get_roll_pitch(&r, &p);
    TEST_ASSERT_FLOAT_WITHIN(1e-4f, alpha_of(0.01f) * 0.1f, r);
    TEST_ASSERT_FLOAT_WITHIN(1e-4f, alpha_of(0.01f) * -0.2f, p);
}

void test_est_gyro_1_s_at_30_dps_is_about_30_deg(void) {
    float r = 0, p = 0;
    /* tilt and gyro agree: the drone rotates at 30 deg/s */
    for (int i = 1; i <= 100; i++) {
        set_tilt(30.0f * i / 100.0f, 0.0f);
        set_vel_ang(30.0f, 0.0f, 0.0f);
        t_now += 10000000LL;
        set_time_imu(t_now);
        get_roll_pitch(&r, &p);
    }
    TEST_ASSERT_FLOAT_WITHIN(1.0f, 30.0f, r);
}

void test_est_saves_the_estimate_and_the_time(void) {
    float r, p;
    set_tilt(10.0f, 5.0f);
    t_now += DT_NS; set_time_imu(t_now);
    get_roll_pitch(&r, &p);
    TEST_ASSERT_EQUAL_FLOAT(r, last_rpy.roll);
    TEST_ASSERT_EQUAL_FLOAT(p, last_rpy.pitch);
    TEST_ASSERT_EQUAL_INT64(t_now, last_rpy.t_stamp);
}

void test_est_first_sample_long_dt_is_ignored(void) {
    /* after boot last_rpy.t_stamp = 0: dt would be huge */
    float r, p;
    last_rpy.t_stamp = 0;
    set_vel_ang(100.0f, 0, 0);
    set_time_imu(5000000000LL);
    get_roll_pitch(&r, &p);
    TEST_ASSERT_FLOAT_WITHIN(1e-4f, 0.0f, r);
}

void test_est_zero_dt_does_not_integrate(void) {
    float r, p;
    set_vel_ang(100.0f, 100.0f, 0);
    set_time_imu(last_rpy.t_stamp);
    get_roll_pitch(&r, &p);
    TEST_ASSERT_FLOAT_WITHIN(1e-5f, 0.0f, r);
    TEST_ASSERT_FLOAT_WITHIN(1e-5f, 0.0f, p);
}

void test_est_negative_dt_is_ignored(void) {
    float r, p;
    set_vel_ang(100.0f, 0, 0);
    set_time_imu(last_rpy.t_stamp - DT_NS);
    get_roll_pitch(&r, &p);
    TEST_ASSERT_FLOAT_WITHIN(1e-5f, 0.0f, r);
}

void test_est_accel_units_do_not_matter(void) {
    /* In simulation the acceleration arrives in m/s^2: atan2 gives the same angle */
    float r1, p1, r2, p2;
    set_acc_lin(-0.2f, 0.3f, 0.93f);
    t_now += DT_NS; set_time_imu(t_now);
    get_roll_pitch(&r1, &p1);
    memset(&last_rpy, 0, sizeof last_rpy);
    last_rpy.t_stamp = t_now;
    set_acc_lin(-0.2f * 9.81f, 0.3f * 9.81f, 0.93f * 9.81f);
    t_now += DT_NS; set_time_imu(t_now);
    get_roll_pitch(&r2, &p2);
    TEST_ASSERT_FLOAT_WITHIN(1e-4f, r1, r2);
    TEST_ASSERT_FLOAT_WITHIN(1e-4f, p1, p2);
}

/* ------------------------------------------------------------------ */
/*                   3. OUTER LOOP: cmd_vel -> roll/pitch             */
/* ------------------------------------------------------------------ */
static geometry_msgs__msg__Twist vel(double vx, double vy) {
    geometry_msgs__msg__Twist t = { 0 };
    t.linear.x = vx;
    t.linear.y = vy;
    return t;
}


void test_ext_zero_velocity_gives_zero_angles(void) {
    float r = 9, p = 9;
    cmd_vel_2_RP(&r, &p, vel(0, 0));
    TEST_ASSERT_FLOAT_WITHIN(1e-6f, 0.0f, r);
    TEST_ASSERT_FLOAT_WITHIN(1e-6f, 0.0f, p);
}

/* Below MAX_ANGLE the angle is proportional to the velocity. */
void test_ext_is_linear_below_the_limit(void) {
    float r1, p1, r2, p2;
    cmd_vel_2_RP(&r1, &p1, vel(1.0, 1.0));
    cmd_vel_2_RP(&r2, &p2, vel(2.0, 2.0));
    TEST_ASSERT_TRUE(fabsf(r1) > 0.0f && fabsf(r1) < MAX_ANGLE);
    TEST_ASSERT_FLOAT_WITHIN(1e-6f, 2.0f * r1, r2);
    TEST_ASSERT_FLOAT_WITHIN(1e-6f, 2.0f * p1, p2);
}

/* [BUG] cmd_vel_2_RP() computes the roll from vx and the pitch from vy
 * (swapped): going forwards tilts the drone sideways. The same defect makes
 * the next 3 tests and test_int_forward_command_moves_the_pitch_channel fail. */
void test_ext_forward_velocity_gives_positive_pitch_only(void) {
    float r, p;
    cmd_vel_2_RP(&r, &p, vel(1.5, 0));
    TEST_ASSERT_TRUE(p > 0.0f);
    TEST_ASSERT_FLOAT_WITHIN(1e-6f, 0.0f, r);
}

/* ENU: y is the left, and a positive roll pushes to -y. */
void test_ext_lateral_velocity_gives_negative_roll_only(void) {
    float r, p;
    cmd_vel_2_RP(&r, &p, vel(0, 1.5));
    TEST_ASSERT_TRUE(r < 0.0f);
    TEST_ASSERT_FLOAT_WITHIN(1e-6f, 0.0f, p);
}

/* [BUG] Roll and pitch swapped (see above): going backwards (vx < 0)
 * changes the roll, not the pitch. */
void test_ext_backward_velocity_gives_negative_pitch(void) {
    float r, p;
    cmd_vel_2_RP(&r, &p, vel(-1.5, 0));
    TEST_ASSERT_TRUE_MESSAGE(p < 0.0f, "backwards must tilt the other way");
}

void test_ext_right_velocity_gives_positive_roll(void) {
    float r, p;
    cmd_vel_2_RP(&r, &p, vel(0, -1.5));
    TEST_ASSERT_TRUE_MESSAGE(r > 0.0f, "right must tilt the other way");
}

/* The output must be odd: f(-v) = -f(v). */
void test_ext_is_odd_symmetric(void) {
    for (double v = 0.25; v <= 4.0; v += 0.25) {
        float r1, p1, r2, p2;
        cmd_vel_2_RP(&r1, &p1, vel(v, v * 0.5));
        cmd_vel_2_RP(&r2, &p2, vel(-v, -v * 0.5));
        TEST_ASSERT_FLOAT_WITHIN(1e-6f, -r1, r2);
        TEST_ASSERT_FLOAT_WITHIN(1e-6f, -p1, p2);
    }
}

void test_ext_grows_with_the_speed(void) {
    float prev = -1.0f;
    for (double v = 0.0; v <= 10.0; v += 0.25) {
        float r, p;
        cmd_vel_2_RP(&r, &p, vel(v, 0));
        float tilt = fabsf(r) + fabsf(p);   /* does not depend on the axis */
        TEST_ASSERT_TRUE(tilt >= prev);
        prev = tilt;
    }
}

void test_ext_diagonal_gives_equal_roll_and_pitch(void) {
    float r, p;
    cmd_vel_2_RP(&r, &p, vel(1.0, 1.0));
    TEST_ASSERT_FLOAT_WITHIN(1e-6f, -r, p);
}

void test_ext_is_limited_to_max_angle(void) {
    float r, p;
    cmd_vel_2_RP(&r, &p, vel(50.0, 50.0));
    TEST_ASSERT_FLOAT_WITHIN(1e-6f, -MAX_ANGLE, r);
    TEST_ASSERT_FLOAT_WITHIN(1e-6f, MAX_ANGLE, p);
}

/* Velocity loop: the angle is KP_VEL x (command - measured velocity). */
void test_ext_command_gives_kp_vel_per_m_s(void) {
    float r, p;
    cmd_vel_2_RP(&r, &p, vel(1.0, 0));
    TEST_ASSERT_FLOAT_WITHIN(1e-6f, KP_VEL, p);
}

/* Hover (cmd_vel = 0) with a drift forwards: it tilts backwards to brake. */
void test_ext_hover_brakes_a_forward_drift(void) {
    set_vel_lin(0.5f, 0, 0);
    float r, p;
    cmd_vel_2_RP(&r, &p, vel(0, 0));
    TEST_ASSERT_FLOAT_WITHIN(1e-6f, -KP_VEL * 0.5f, p);
    TEST_ASSERT_FLOAT_WITHIN(1e-6f, 0.0f, r);
}

/* Hover with a drift to the left (+y): positive roll pushes it to -y. */
void test_ext_hover_brakes_a_left_drift(void) {
    set_vel_lin(0, 0.5f, 0);
    float r, p;
    cmd_vel_2_RP(&r, &p, vel(0, 0));
    TEST_ASSERT_FLOAT_WITHIN(1e-6f, KP_VEL * 0.5f, r);
    TEST_ASSERT_FLOAT_WITHIN(1e-6f, 0.0f, p);
}

/* Without drift the drone stays level. */
void test_ext_at_the_commanded_velocity_it_is_level(void) {
    set_vel_lin(0.3f, -0.2f, 0);
    float r, p;
    cmd_vel_2_RP(&r, &p, vel(0.3, -0.2));
    TEST_ASSERT_FLOAT_WITHIN(1e-6f, 0.0f, r);
    TEST_ASSERT_FLOAT_WITHIN(1e-6f, 0.0f, p);
}

/* The velocity of the odometry is in world axes and cmd_vel in the axes of
 * the drone: turned 90 deg in yaw, +y of the world is forwards. */
void test_ext_velocity_is_turned_with_the_yaw(void) {
    set_orientation(0, 0, sinf(RAD(90.0) / 2), cosf(RAD(90.0) / 2));
    set_vel_lin(0, 0.5f, 0);
    float r, p;
    cmd_vel_2_RP(&r, &p, vel(0, 0));
    TEST_ASSERT_FLOAT_WITHIN(1e-5f, -KP_VEL * 0.5f, p);
    TEST_ASSERT_FLOAT_WITHIN(1e-5f, 0.0f, r);
}

/* kp_vel can be changed while flying (tuning task). */
void test_ext_uses_the_kp_vel_gain(void) {
    GAINS k = default_gains;
    k.kp_vel = 2.0f * KP_VEL;
    set_gains(&k);
    float r, p;
    cmd_vel_2_RP(&r, &p, vel(1.0, 0));
    TEST_ASSERT_FLOAT_WITHIN(1e-6f, 2.0f * KP_VEL, p);
}

void test_ext_never_over_max_angle(void) {
    for (double vx = -30; vx <= 30; vx += 1.5)
        for (double vy = -30; vy <= 30; vy += 1.5) {
            float r, p;
            cmd_vel_2_RP(&r, &p, vel(vx, vy));
            TEST_ASSERT_TRUE(fabsf(r) <= MAX_ANGLE + 1e-6f);
            TEST_ASSERT_TRUE(fabsf(p) <= MAX_ANGLE + 1e-6f);
        }
}

void test_ext_max_angle_is_20_deg(void) {
    TEST_ASSERT_FLOAT_WITHIN(0.5f, 20.0f, (float)DEG(MAX_ANGLE));
}

/* ------------------------------------------------------------------ */
/*                    4. INNER LOOP AND MOTOR MIX                     */
/* ------------------------------------------------------------------ */
void test_int_one_motor_command_per_cycle(void) {
    step();
    step();
    TEST_ASSERT_EQUAL_INT(2, motor_calls);
}

void test_int_outputs_are_finite(void) {
    set_vel_ang(1000.0f, -1000.0f, 500.0f);
    set_acc_lin(0, 0, 0);
    mock_target.cmd_vel = vel(3.0, -2.0);
    mock_target.h = 2.0f;
    step();
    for (int i = 0; i < N_MOTORS; i++) TEST_ASSERT_FALSE(isnan(motors[i]) || isinf(motors[i]));
}

void test_int_level_and_still_all_motors_are_equal(void) {
    step();
    for (int i = 1; i < N_MOTORS; i++) TEST_ASSERT_DOUBLE_WITHIN(1e-9, motors[0], motors[i]);
}

/* At the target height (and still) every motor gets the hover throttle. */
void test_int_at_target_height_motors_get_the_hover_throttle(void) {
    set_baro(0.5f);
    mock_target.h = 0.5f;
    settle();
    for (int i = 0; i < N_MOTORS; i++)
        TEST_ASSERT_DOUBLE_WITHIN_MESSAGE(1.0, BASE, motors[i], "hover needs THROTTLE_BASE on every motor");
}

void test_int_roll_rate_error_only_moves_the_roll_channel(void) {
    set_vel_ang(-10.0f, 0, 0);   /* the drone rolls at -10 deg/s, it should be 0 */
    step_same_time();
    Mix c = decompose();
    TEST_ASSERT_DOUBLE_WITHIN(1e-3, KP_RATE * 10.0, c.r);
    TEST_ASSERT_DOUBLE_WITHIN(1e-6, 0.0, c.p);
    TEST_ASSERT_DOUBLE_WITHIN(1e-6, 0.0, c.y);
}

void test_int_pitch_rate_error_only_moves_the_pitch_channel(void) {
    set_vel_ang(0, 8.0f, 0);
    step_same_time();
    Mix c = decompose();
    TEST_ASSERT_DOUBLE_WITHIN(1e-3, KP_RATE * -8.0, c.p);
    TEST_ASSERT_DOUBLE_WITHIN(1e-6, 0.0, c.r);
    TEST_ASSERT_DOUBLE_WITHIN(1e-6, 0.0, c.y);
}

/* A huge error must not take all the throttle: each roll/pitch/yaw term
 * is limited to MAX_POW_RPY so the motors keep the hover thrust. */
void test_int_attitude_power_is_limited(void) {
    /* Big enough to saturate with any of the gains */
    set_vel_ang(-100000.0f, 100000.0f, 100000.0f);
    step_same_time();
    Mix c = decompose();
    TEST_ASSERT_DOUBLE_WITHIN(1e-3, MAX_POW_RPY, c.r);
    TEST_ASSERT_DOUBLE_WITHIN(1e-3, -MAX_POW_RPY, c.p);
    TEST_ASSERT_DOUBLE_WITHIN(1e-3, -MAX_POW_YAW, c.y);
}

/* Yaw has its own limit, smaller than the one of roll / pitch. */
void test_int_yaw_power_is_limited_to_max_pow_yaw(void) {
    set_vel_ang(0, 0, 1000.0f);
    step_same_time();
    TEST_ASSERT_DOUBLE_WITHIN(1e-3, -MAX_POW_YAW, decompose().y);
}

void test_int_yaw_follows_cmd_vel_angular_z(void) {
    mock_target.cmd_vel.angular.z = 0.5;   /* rad/s, small so it is not limited by MAX_POW_YAW */
    step_same_time();
    Mix c = decompose();
    TEST_ASSERT_DOUBLE_WITHIN(0.1, KP_YAW_RATE * DEG(0.5), c.y);
    TEST_ASSERT_DOUBLE_WITHIN(1e-6, 0.0, c.r);
    TEST_ASSERT_DOUBLE_WITHIN(1e-6, 0.0, c.p);
}

void test_int_yaw_at_the_target_rate_gives_zero_yaw(void) {
    mock_target.cmd_vel.angular.z = 0.5;
    set_vel_ang(0, 0, (float)DEG(0.5));
    step_same_time();
    TEST_ASSERT_DOUBLE_WITHIN(0.01, 0.0, decompose().y);
}

void test_int_response_is_proportional_to_the_error(void) {
    set_vel_ang(-5.0f, 0, 0);
    step_same_time();
    double r1 = decompose().r;
    set_vel_ang(-10.0f, 0, 0);
    step_same_time();
    double r2 = decompose().r;
    TEST_ASSERT_DOUBLE_WITHIN(1e-3, 2.0 * r1, r2);
}

void test_int_mix_does_not_change_the_collective_thrust(void) {
    step_same_time();
    double h0 = decompose().h;
    set_vel_ang(-20.0f, 15.0f, 10.0f);
    step_same_time();
    TEST_ASSERT_DOUBLE_WITHIN(1e-6, h0, decompose().h);
}

void test_int_mix_is_x_frame(void) {
    /* opposite motors (0-3, 1-2) turn the same way: same sign of yaw */
    mock_target.cmd_vel.angular.z = 1.0;
    step_same_time();
    TEST_ASSERT_TRUE((motors[0] - motors[1]) * (motors[3] - motors[2]) > 0);
    TEST_ASSERT_DOUBLE_WITHIN(1e-6, motors[0], motors[3]);
    TEST_ASSERT_DOUBLE_WITHIN(1e-6, motors[1], motors[2]);
}

void test_int_tilt_is_opposed(void) {
    /* rolled +10 deg and still: the controller must roll back (r < 0) */
    last_rpy.roll = 10.0f;
    set_tilt(10.0f, 0.0f);
    step_same_time();
    TEST_ASSERT_TRUE(decompose().r < 0.0);
}

void test_int_pitch_tilt_is_opposed(void) {
    last_rpy.pitch = -10.0f;
    set_tilt(0.0f, -10.0f);
    step_same_time();
    TEST_ASSERT_TRUE(decompose().p > 0.0);
}

/* [BUG] Roll and pitch swapped in cmd_vel_2_RP() (see test_ext_*). */
void test_int_forward_command_moves_the_pitch_channel(void) {
    mock_target.cmd_vel = vel(2.0, 0);
    step_same_time();
    Mix c = decompose();
    TEST_ASSERT_TRUE(c.p > 0.0);
    TEST_ASSERT_DOUBLE_WITHIN(1e-6, 0.0, c.r);
}

void test_int_no_error_when_the_tilt_is_the_target(void) {
    /* target roll / pitch for (2, 1) m/s, and the drone already has them */
    float tr, tp;
    cmd_vel_2_RP(&tr, &tp, vel(2.0, 1.0));
    mock_target.cmd_vel = vel(2.0, 1.0);
    last_rpy.roll = (float)DEG(tr);
    last_rpy.pitch = (float)DEG(tp);
    set_tilt((float)DEG(tr), (float)DEG(tp));
    step_same_time();
    TEST_ASSERT_DOUBLE_WITHIN(0.5, 0.0, decompose().r);
    TEST_ASSERT_DOUBLE_WITHIN(0.5, 0.0, decompose().p);
}

/* ------------------------------------------------------------------ */
/*                              5. HEIGHT                             */
/* ------------------------------------------------------------------ */
void test_h_below_target_more_thrust(void) {
    mock_target.h = 1.0f;
    set_baro(1.0f);
    settle();
    double at = decompose().h;
    set_baro(0.5f);
    settle();
    TEST_ASSERT_TRUE(decompose().h > at);
}

void test_h_above_target_less_thrust(void) {
    mock_target.h = 1.0f;
    set_baro(1.0f);
    settle();
    double at = decompose().h;
    set_baro(1.5f);
    settle();
    TEST_ASSERT_TRUE(decompose().h < at);
}

void test_h_thrust_is_proportional_to_the_error(void) {
    mock_target.h = 1.0f;
    set_baro(1.0f);
    settle();
    double at = decompose().h;
    set_baro(0.8f);
    settle();
    double d1 = decompose().h - at;
    set_baro(0.6f);
    settle();
    double d2 = decompose().h - at;
    TEST_ASSERT_DOUBLE_WITHIN(1e-3, 2.0 * d1, d2);
}

void test_h_error_is_saved(void) {
    mock_target.h = 1.0f;
    set_baro(0.7f);
    settle();
    TEST_ASSERT_FLOAT_WITHIN(1e-5f, 0.3f, err_h);
}

void test_h_reached_at_the_target(void) {
    mock_target.h = 1.0f;
    set_baro(1.0f);
    settle();
    TEST_ASSERT_TRUE(check_h_reached());
}

void test_h_reached_inside_diff_h_allowed(void) {
    TEST_ASSERT_FLOAT_WITHIN(1e-6f, 0.05f, DIFF_H_ALLOWED);
    mock_target.h = 1.0f;
    set_baro(0.97f);
    settle();
    TEST_ASSERT_TRUE(check_h_reached());
    set_baro(1.03f);
    settle();
    TEST_ASSERT_TRUE(check_h_reached());
}

void test_h_not_reached_outside_diff_h_allowed(void) {
    mock_target.h = 1.0f;
    set_baro(0.93f);
    settle();
    TEST_ASSERT_FALSE(check_h_reached());
    set_baro(1.07f);
    settle();
    TEST_ASSERT_FALSE(check_h_reached());
}

/* At the target, but it has to stay there TIME_H_STABLE_MS (500 ms). */
void test_h_reached_only_after_time_h_stable(void) {
    TEST_ASSERT_EQUAL_INT(500, TIME_H_STABLE_MS);
    mock_target.h = 0.0f;   /* already at the target (ground = 0 m) */
    int steps = 0;
    while (!check_h_reached() && steps < 100) { step(); steps++; }
    /* 500 ms / 15 ms = 33.3 -> reached in the cycle 35 (the first one starts the timer) */
    TEST_ASSERT_TRUE(check_h_reached());
    TEST_ASSERT_INT_WITHIN(1, 35, steps);
}

void test_h_not_reached_while_the_vertical_velocity_is_high(void) {
    mock_target.h = 0.0f;
    settle();
    TEST_ASSERT_TRUE(check_h_reached());
    last_vel_z = 2.0f * V_STABLE;   /* moving up/down at the target height */
    step_same_time();
    TEST_ASSERT_FALSE(check_h_reached());
}

void test_h_leaving_the_target_restarts_the_timer(void) {
    mock_target.h = 0.0f;
    settle();
    TEST_ASSERT_TRUE(check_h_reached());
    mock_target.h = 1.0f;   /* new target, far away */
    step();
    TEST_ASSERT_FALSE(check_h_reached());
    TEST_ASSERT_EQUAL_INT64(-1, t_h_reached_us);
    mock_target.h = 0.0f;   /* back at the target: wait again */
    step();
    TEST_ASSERT_FALSE(check_h_reached());
}

/* [BUG] control_attitude() ends with set_h(h): it writes the estimated
 * height (relative to the ground) in the same place of the state where the
 * barometer writes the absolute altitude (pos.z). If the next cycle runs
 * before a new barometer sample, get_h() reads its own estimate as the
 * barometer: with the real BMP180 (altitude ~ 600 m) err_baro = h - h0
 * becomes ~ -600 m. */
void test_h_control_does_not_overwrite_the_barometer(void) {
    set_baro(600.0f);
    h_init = false;
    set_time_height(t_now);
    step();                 /* first sample: ground = 600 m */
    set_baro(600.5f);
    step();
    vec3_t p;
    get_position(&p);
    TEST_ASSERT_FLOAT_WITHIN_MESSAGE(1e-3f, 600.5f, p.z, "pos.z is the barometer altitude");
}

void test_h_not_reached_far_away(void) {
    mock_target.h = 2.0f;
    set_baro(0.0f);
    settle();
    TEST_ASSERT_FALSE(check_h_reached());
}

/* reset_h_reached(): called by system.c when the target height changes. */
void test_h_reset_clears_the_flag_and_the_timer(void) {
    mock_target.h = 1.0f;
    set_baro(1.0f);
    settle();
    TEST_ASSERT_TRUE(check_h_reached());
    TEST_ASSERT_TRUE(t_h_reached_us >= 0);
    reset_h_reached();
    TEST_ASSERT_FALSE(check_h_reached());
    TEST_ASSERT_EQUAL_INT64(-1, t_h_reached_us);
}

/* After the reset the drone has to stay TIME_H_STABLE_MS at the target again. */
void test_h_reset_waits_time_h_stable_again(void) {
    mock_target.h = 0.0f;
    settle();
    TEST_ASSERT_TRUE(check_h_reached());
    reset_h_reached();
    step();
    TEST_ASSERT_FALSE_MESSAGE(check_h_reached(), "the first cycle only starts the timer");
    int steps = 1;
    while (!check_h_reached() && steps < 100) { step(); steps++; }
    TEST_ASSERT_TRUE(check_h_reached());
    TEST_ASSERT_INT_WITHIN(1, 35, steps);
}

/* Landing: hover height reached, reset, new target 0 m. It is not reached
 * until the drone is on the ground. */
void test_h_reset_and_new_target_is_reached_only_there(void) {
    mock_target.h = 1.0f;
    set_baro(1.0f);
    settle();
    TEST_ASSERT_TRUE(check_h_reached());
    reset_h_reached();
    mock_target.h = 0.0f;
    step();
    TEST_ASSERT_FALSE(check_h_reached());
    set_baro(0.0f);
    settle();
    TEST_ASSERT_TRUE(check_h_reached());
}

void test_h_reset_when_not_reached_does_nothing(void) {
    reset_h_reached();
    TEST_ASSERT_FALSE(check_h_reached());
    TEST_ASSERT_EQUAL_INT64(-1, t_h_reached_us);
    mock_target.h = 0.0f;
    settle();
    TEST_ASSERT_TRUE(check_h_reached());
}

/* It only clears the flag: the height filter and the gains are not touched. */
void test_h_reset_does_not_change_the_estimation_or_the_gains(void) {
    mock_target.h = 1.0f;
    set_baro(0.8f);
    settle();
    float h = h_est, v = last_vel_z, e = err_h;
    GAINS before, after;
    get_gains(&before);
    reset_h_reached();
    get_gains(&after);
    TEST_ASSERT_EQUAL_FLOAT(h, h_est);
    TEST_ASSERT_EQUAL_FLOAT(v, last_vel_z);
    TEST_ASSERT_EQUAL_FLOAT(e, err_h);
    TEST_ASSERT_EQUAL_MEMORY(&before, &after, sizeof before);
}

/* reset_h_reached(), check_h_reached() and control_attitude() take h_lock:
 * they have to leave it free. */
void test_h_reset_releases_the_lock(void) {
    reset_h_reached();
    TEST_ASSERT_EQUAL_INT(0, pthread_mutex_trylock(&h_lock));
    pthread_mutex_unlock(&h_lock);
    check_h_reached();
    step();
    TEST_ASSERT_EQUAL_INT(0, pthread_mutex_trylock(&h_lock));
    pthread_mutex_unlock(&h_lock);
}

/* ------------------------------------------------------------------ */
/*                        6. HEIGHT ESTIMATION                        */
/* ------------------------------------------------------------------ */
void test_hest_waits_for_the_first_barometer_sample(void) {
    h_init = false;
    set_baro(600.0f);          /* no barometer time yet */
    TEST_ASSERT_FLOAT_WITHIN(1e-6f, 0.0f, get_h(0, 0));
    TEST_ASSERT_FALSE(h_init);
}

void test_hest_first_sample_is_the_ground(void) {
    h_init = false;
    set_baro(600.0f);
    set_time_height(t_now);
    TEST_ASSERT_FLOAT_WITHIN(1e-6f, 0.0f, get_h(0, 0));
    TEST_ASSERT_TRUE(h_init);
    TEST_ASSERT_FLOAT_WITHIN(1e-3f, 600.0f, h0);
}

void test_hest_height_is_relative_to_the_ground(void) {
    h_init = false;
    set_baro(600.0f);
    set_time_height(t_now);
    get_h(0, 0);
    set_baro(601.0f);
    settle();
    TEST_ASSERT_FLOAT_WITHIN(0.01f, 1.0f, h_est);
}

void test_hest_still_and_level_does_not_drift(void) {
    settle();
    TEST_ASSERT_FLOAT_WITHIN(1e-3f, 0.0f, h_est);
    TEST_ASSERT_FLOAT_WITHIN(1e-3f, 0.0f, last_vel_z);
}

void test_hest_still_and_tilted_does_not_drift(void) {
    last_rpy.roll = 20.0f;
    last_rpy.pitch = -10.0f;
    set_tilt(20.0f, -10.0f);
    settle();
    TEST_ASSERT_FLOAT_WITHIN(1e-3f, 0.0f, h_est);
    TEST_ASSERT_FLOAT_WITHIN(1e-3f, 0.0f, last_vel_z);
}

void test_hest_converges_to_the_barometer(void) {
    set_baro(1.5f);
    settle();
    TEST_ASSERT_FLOAT_WITHIN(0.01f, 1.5f, h_est);
    TEST_ASSERT_FLOAT_WITHIN(0.01f, 0.0f, last_vel_z);
}

void test_hest_one_step_is_filtered(void) {
    set_baro(1.0f);
    step();
    TEST_ASSERT_FLOAT_WITHIN(1e-4f, K_H_S * (DT_NS / 1e9f) * 1.0f, h_est);
}

/* The barometer correction is per second (K_H_S, K_V_S x dt): 0.3 s at
 * 200 Hz and at 66 Hz give (almost) the same height. */
static float height_after(int64_t step_ns, int steps) {
    h_est = 0.0f;
    last_vel_z = 0.0f;
    last_t_h = t_now;
    set_baro(1.0f);
    float h = 0.0f;
    for (int i = 0; i < steps; i++) {
        t_now += step_ns;
        set_time_imu(t_now);
        h = get_h(0, 0);
    }
    return h;
}

void test_hest_correction_does_not_depend_on_the_frequency(void) {
    float fast = height_after(5000000LL, 60);    /* 60 x 5 ms */
    float slow = height_after(15000000LL, 20);   /* 20 x 15 ms */
    TEST_ASSERT_TRUE(fast > 0.1f);
    TEST_ASSERT_FLOAT_WITHIN(0.05f * fast, slow, fast);
}

void test_hest_upward_acceleration_gives_upward_velocity(void) {
    set_acc_lin(0, 0, 1.5f);   /* +0.5 g over the gravity */
    for (int i = 0; i < 10; i++) step();
    TEST_ASSERT_TRUE(last_vel_z > 0.0f);
    TEST_ASSERT_TRUE(h_est > 0.0f);
}

void test_hest_integrates_with_the_imu_time_in_s(void) {
    /* One step of 15 ms at +1 g over the gravity, barometer still at 0 */
    set_acc_lin(0, 0, 2.0f);
    step_same_time();          /* dt = 0: nothing is integrated */
    TEST_ASSERT_FLOAT_WITHIN(1e-6f, 0.0f, last_vel_z);
    step();
    float dt = DT_NS / 1e9f;
    float h_pred = 0.5f * K_G * dt * dt;
    TEST_ASSERT_FLOAT_WITHIN(1e-4f, K_G * dt - K_V_S * dt * h_pred, last_vel_z);
}

void test_hest_long_dt_is_ignored(void) {
    set_acc_lin(0, 0, 2.0f);
    t_now += 1000000000LL;     /* 1 s without IMU data */
    step();
    TEST_ASSERT_FLOAT_WITHIN(1e-6f, 0.0f, last_vel_z);
}

void test_hest_get_vel_z_returns_the_estimated_velocity(void) {
    set_acc_lin(0, 0, 1.5f);
    for (int i = 0; i < 10; i++) step();
    TEST_ASSERT_TRUE(get_vel_z() > 0.0f);
    TEST_ASSERT_EQUAL_FLOAT(last_vel_z, get_vel_z());
}

void test_hest_get_vel_z_is_zero_when_still(void) {
    settle();
    TEST_ASSERT_FLOAT_WITHIN(1e-3f, 0.0f, get_vel_z());
}

/* ------------------------------------------------------------------ */
/*                              7. GAINS                              */
/* ------------------------------------------------------------------ */
void test_gains_start_with_the_defines(void) {
    GAINS k;
    get_gains(&k);
    TEST_ASSERT_EQUAL_FLOAT(KP_H, k.kp_h);
    TEST_ASSERT_EQUAL_FLOAT(KD_H, k.kd_h);
    TEST_ASSERT_EQUAL_FLOAT(KP_VEL, k.kp_vel);
    TEST_ASSERT_EQUAL_FLOAT(KP_ANGLE, k.kp_angle);
    TEST_ASSERT_EQUAL_FLOAT(KP_RATE, k.kp_rate);
    TEST_ASSERT_EQUAL_FLOAT(KI_RATE, k.ki_rate);
    TEST_ASSERT_EQUAL_FLOAT(KP_YAW_RATE, k.kp_yaw_rate);
    TEST_ASSERT_EQUAL_FLOAT(MAX_RATE, k.max_rate);
    TEST_ASSERT_EQUAL_FLOAT(MAX_POW_RPY, k.max_pow_rpy);
    TEST_ASSERT_EQUAL_FLOAT(THROTTLE_BASE, k.base);
}

void test_gains_set_and_get(void) {
    GAINS in = default_gains, out;
    in.kp_h = 1.0f;
    in.kd_h = 2.0f;
    in.base = 3.0f;
    set_gains(&in);
    get_gains(&out);
    TEST_ASSERT_EQUAL_MEMORY(&in, &out, sizeof in);
}

void test_gains_are_used_by_the_controller(void) {
    GAINS k = default_gains;
    k.kp_rate = 2.0f * default_gains.kp_rate;
    set_gains(&k);
    set_vel_ang(-10.0f, 0, 0);
    step_same_time();
    TEST_ASSERT_DOUBLE_WITHIN(1e-3, k.kp_rate * 10.0, decompose().r);
}

void test_gains_base_is_the_collective_thrust(void) {
    GAINS k = default_gains;
    k.base = 1000.0f;
    set_gains(&k);
    step_same_time();
    TEST_ASSERT_DOUBLE_WITHIN(1e-3, 1000.0, decompose().h);
}

/* The vertical velocity is damped with kd_h. */
void test_gains_kd_h_opposes_the_vertical_velocity(void) {
    last_vel_z = 0.1f;
    step_same_time();
    double up = decompose().h;
    last_vel_z = 0.0f;
    step_same_time();
    double still = decompose().h;
    TEST_ASSERT_DOUBLE_WITHIN(1e-3, -KD_H * 0.1, up - still);
}

/* ------------------------------------------------------------------ */
/*                           8. TASK / INIT                           */
/* ------------------------------------------------------------------ */
void test_task_init_creates_the_task_with_the_menuconfig_values(void) {
    init_attitude_controller();
    const mock_task_t *t = mock_find_task("attitude_task");
    TEST_ASSERT_NOT_NULL(t);
    TEST_ASSERT_EQUAL_UINT32(CONFIG_ATTITUDE_TASK_STACK, t->stack);
    TEST_ASSERT_EQUAL_UINT(CONFIG_ATTITUDE_TASK_PRIO, t->prio);
}

/* [BUG] Every other module ignores a second init (is_init). Here a second
 * call creates a second controller task that also drives the motors. */
void test_task_init_twice_creates_one_task(void) {
    init_attitude_controller();
    init_attitude_controller();
    TEST_ASSERT_EQUAL_INT(1, mock_task_count);
}

/* 5 ms (200 Hz) in the drone, 15 ms in simulation (this suite is hw). */
void test_task_period_is_attitude_task_period_ms(void) {
    TEST_ASSERT_EQUAL_INT(5, ATTITUDE_TASK_PERIOD_MS);
    mock_run_task(attitude_task, NULL, 10);
    TEST_ASSERT_EQUAL_UINT64(10 * ATTITUDE_TASK_PERIOD_MS, mock_delay_total_ms);
}

void test_task_controls_every_cycle(void) {
    mock_run_task(attitude_task, NULL, 10);
    TEST_ASSERT_EQUAL_INT(10, motor_calls);
}

/* ------------------------------------------------------------------ */
/*            9. INTEGRAL OF THE RATE AND GAIN OF THE YAW             */
/* ------------------------------------------------------------------ */
void test_i_accumulates_the_rate_error_while_flying(void) {
    set_sm_state(HOVERING);
    set_vel_ang(-10.0f, 0, 0);          /* roll rate error of ~+10 deg/s */
    step();
    float dt = DT_NS / 1e9f;
    TEST_ASSERT_FLOAT_WITHIN(0.003f, KI_RATE * 10.0f * dt, i_roll);
    TEST_ASSERT_FLOAT_WITHIN(1e-6f, 0.0f, i_pitch);
}

void test_i_grows_while_the_error_lasts(void) {
    set_sm_state(HOVERING);
    set_vel_ang(0, -10.0f, 0);
    step();
    float one = i_pitch;
    for (int i = 0; i < 4; i++) step();
    TEST_ASSERT_TRUE(one > 0.0f);
    TEST_ASSERT_TRUE(i_pitch > 4.0f * one);
}

/* Also taking off: the torque of the CoM appears when it leaves the ground. */
void test_i_works_while_taking_off(void) {
    set_sm_state(TAKING_OFF);
    set_vel_ang(-10.0f, 0, 0);
    step();
    TEST_ASSERT_TRUE(i_roll > 0.0f);
}

void test_i_is_limited(void) {
    set_sm_state(HOVERING);
    i_roll = 1000.0f;
    i_pitch = -1000.0f;
    step();
    TEST_ASSERT_FLOAT_WITHIN(1e-3f, MAX_I_RATE, i_roll);
    TEST_ASSERT_FLOAT_WITHIN(1e-3f, -MAX_I_RATE, i_pitch);
}

/* Without error the integral keeps the torque it learned. */
void test_i_holds_the_torque_without_error(void) {
    set_sm_state(HOVERING);
    i_pitch = 20.0f;
    step_same_time();
    TEST_ASSERT_DOUBLE_WITHIN(1e-3, 20.0, decompose().p);
}

/* Out of the flight states (ARMING, DISARMING...) it goes back to 0. */
void test_i_is_0_out_of_the_flight(void) {
    sm_states_t states[] = { INIT, CHECKING, ARMING, DISARMING, ERROR };
    for (unsigned s = 0; s < sizeof states / sizeof states[0]; s++) {
        set_sm_state(states[s]);
        i_roll = 20.0f;
        i_pitch = -20.0f;
        step();
        TEST_ASSERT_FLOAT_WITHIN(1e-6f, 0.0f, i_roll);
        TEST_ASSERT_FLOAT_WITHIN(1e-6f, 0.0f, i_pitch);
    }
}

/* The same IMU sample again (dt = 0) adds nothing. */
void test_i_does_not_change_with_the_same_imu_sample(void) {
    set_sm_state(HOVERING);
    set_vel_ang(-10.0f, 0, 0);
    step_same_time();
    TEST_ASSERT_FLOAT_WITHIN(1e-6f, 0.0f, i_roll);
}

void test_i_is_not_used_in_yaw(void) {
    set_sm_state(HOVERING);
    set_vel_ang(0, 0, -10.0f);
    step();
    TEST_ASSERT_DOUBLE_WITHIN(1e-3, KP_YAW_RATE * 10.0, decompose().y);
}

/* ki_rate and kp_yaw_rate can be changed while flying (tuning task). */
void test_i_gains_can_be_changed(void) {
    GAINS k = default_gains;
    k.ki_rate = 0.0f;
    k.kp_yaw_rate = 1.0f;
    set_gains(&k);
    set_sm_state(HOVERING);
    set_vel_ang(-10.0f, 0, -10.0f);
    step();
    TEST_ASSERT_FLOAT_WITHIN(1e-6f, 0.0f, i_roll);
    TEST_ASSERT_DOUBLE_WITHIN(1e-3, 10.0, decompose().y);
}

int main(void) {
    UNITY_BEGIN();

    RUN_TEST(test_comp_alpha_1_returns_the_first);
    RUN_TEST(test_comp_alpha_0_returns_the_second);
    RUN_TEST(test_comp_blend_value);
    RUN_TEST(test_comp_alpha_trusts_the_gyro);
    RUN_TEST(test_comp_alpha_at_15_ms_is_the_old_0_98);
    RUN_TEST(test_comp_alpha_of_0_is_1);
    RUN_TEST(test_comp_correction_does_not_depend_on_the_frequency);

    RUN_TEST(test_est_level_and_still_is_zero);
    RUN_TEST(test_est_accel_converges_to_the_roll);
    RUN_TEST(test_est_accel_converges_to_the_pitch);
    RUN_TEST(test_est_one_step_of_the_accel_is_2_percent);
    RUN_TEST(test_est_gyro_is_integrated_with_the_timestamps);
    RUN_TEST(test_est_gyro_1_s_at_30_dps_is_about_30_deg);
    RUN_TEST(test_est_saves_the_estimate_and_the_time);
    RUN_TEST(test_est_first_sample_long_dt_is_ignored);
    RUN_TEST(test_est_zero_dt_does_not_integrate);
    RUN_TEST(test_est_negative_dt_is_ignored);
    RUN_TEST(test_est_accel_units_do_not_matter);

    RUN_TEST(test_ext_zero_velocity_gives_zero_angles);
    RUN_TEST(test_ext_is_linear_below_the_limit);
    RUN_TEST(test_ext_forward_velocity_gives_positive_pitch_only);
    RUN_TEST(test_ext_lateral_velocity_gives_negative_roll_only);
    RUN_TEST(test_ext_backward_velocity_gives_negative_pitch);
    RUN_TEST(test_ext_right_velocity_gives_positive_roll);
    RUN_TEST(test_ext_is_odd_symmetric);
    RUN_TEST(test_ext_grows_with_the_speed);
    RUN_TEST(test_ext_diagonal_gives_equal_roll_and_pitch);
    RUN_TEST(test_ext_is_limited_to_max_angle);
    RUN_TEST(test_ext_never_over_max_angle);
    RUN_TEST(test_ext_max_angle_is_20_deg);
    RUN_TEST(test_ext_command_gives_kp_vel_per_m_s);
    RUN_TEST(test_ext_hover_brakes_a_forward_drift);
    RUN_TEST(test_ext_hover_brakes_a_left_drift);
    RUN_TEST(test_ext_at_the_commanded_velocity_it_is_level);
    RUN_TEST(test_ext_velocity_is_turned_with_the_yaw);
    RUN_TEST(test_ext_uses_the_kp_vel_gain);

    RUN_TEST(test_int_one_motor_command_per_cycle);
    RUN_TEST(test_int_outputs_are_finite);
    RUN_TEST(test_int_level_and_still_all_motors_are_equal);
    RUN_TEST(test_int_at_target_height_motors_get_the_hover_throttle);
    RUN_TEST(test_int_roll_rate_error_only_moves_the_roll_channel);
    RUN_TEST(test_int_pitch_rate_error_only_moves_the_pitch_channel);
    RUN_TEST(test_int_attitude_power_is_limited);
    RUN_TEST(test_int_yaw_power_is_limited_to_max_pow_yaw);
    RUN_TEST(test_int_yaw_follows_cmd_vel_angular_z);
    RUN_TEST(test_int_yaw_at_the_target_rate_gives_zero_yaw);
    RUN_TEST(test_int_response_is_proportional_to_the_error);
    RUN_TEST(test_int_mix_does_not_change_the_collective_thrust);
    RUN_TEST(test_int_mix_is_x_frame);
    RUN_TEST(test_int_tilt_is_opposed);
    RUN_TEST(test_int_pitch_tilt_is_opposed);
    RUN_TEST(test_int_forward_command_moves_the_pitch_channel);
    RUN_TEST(test_int_no_error_when_the_tilt_is_the_target);

    RUN_TEST(test_h_below_target_more_thrust);
    RUN_TEST(test_h_above_target_less_thrust);
    RUN_TEST(test_h_thrust_is_proportional_to_the_error);
    RUN_TEST(test_h_error_is_saved);
    RUN_TEST(test_h_reached_at_the_target);
    RUN_TEST(test_h_reached_inside_diff_h_allowed);
    RUN_TEST(test_h_not_reached_outside_diff_h_allowed);
    RUN_TEST(test_h_reached_only_after_time_h_stable);
    RUN_TEST(test_h_not_reached_while_the_vertical_velocity_is_high);
    RUN_TEST(test_h_leaving_the_target_restarts_the_timer);
    RUN_TEST(test_h_control_does_not_overwrite_the_barometer);
    RUN_TEST(test_h_not_reached_far_away);
    RUN_TEST(test_h_reset_clears_the_flag_and_the_timer);
    RUN_TEST(test_h_reset_waits_time_h_stable_again);
    RUN_TEST(test_h_reset_and_new_target_is_reached_only_there);
    RUN_TEST(test_h_reset_when_not_reached_does_nothing);
    RUN_TEST(test_h_reset_does_not_change_the_estimation_or_the_gains);
    RUN_TEST(test_h_reset_releases_the_lock);

    RUN_TEST(test_hest_waits_for_the_first_barometer_sample);
    RUN_TEST(test_hest_first_sample_is_the_ground);
    RUN_TEST(test_hest_height_is_relative_to_the_ground);
    RUN_TEST(test_hest_still_and_level_does_not_drift);
    RUN_TEST(test_hest_still_and_tilted_does_not_drift);
    RUN_TEST(test_hest_converges_to_the_barometer);
    RUN_TEST(test_hest_one_step_is_filtered);
    RUN_TEST(test_hest_correction_does_not_depend_on_the_frequency);
    RUN_TEST(test_hest_upward_acceleration_gives_upward_velocity);
    RUN_TEST(test_hest_integrates_with_the_imu_time_in_s);
    RUN_TEST(test_hest_long_dt_is_ignored);
    RUN_TEST(test_hest_get_vel_z_returns_the_estimated_velocity);
    RUN_TEST(test_hest_get_vel_z_is_zero_when_still);

    RUN_TEST(test_gains_start_with_the_defines);
    RUN_TEST(test_gains_set_and_get);
    RUN_TEST(test_gains_are_used_by_the_controller);
    RUN_TEST(test_gains_base_is_the_collective_thrust);
    RUN_TEST(test_gains_kd_h_opposes_the_vertical_velocity);

    RUN_TEST(test_task_init_creates_the_task_with_the_menuconfig_values);
    RUN_TEST(test_task_init_twice_creates_one_task);
    RUN_TEST(test_task_period_is_attitude_task_period_ms);
    RUN_TEST(test_task_controls_every_cycle);

    RUN_TEST(test_i_accumulates_the_rate_error_while_flying);
    RUN_TEST(test_i_grows_while_the_error_lasts);
    RUN_TEST(test_i_works_while_taking_off);
    RUN_TEST(test_i_is_limited);
    RUN_TEST(test_i_holds_the_torque_without_error);
    RUN_TEST(test_i_is_0_out_of_the_flight);
    RUN_TEST(test_i_does_not_change_with_the_same_imu_sample);
    RUN_TEST(test_i_is_not_used_in_yaw);
    RUN_TEST(test_i_gains_can_be_changed);

    return UNITY_END();
}
