ruibartsegura/ESP-Micro_drone/code/esp_code/host_test/mocks/esp_log.h

/* Mock of esp_log.h (host tests): logs are discarded. */
#pragma once
#define ESP_LOGE(tag, fmt, ...) ((void)(tag))
#define ESP_LOGW(tag, fmt, ...) ((void)(tag))
#define ESP_LOGI(tag, fmt, ...) ((void)(tag))
#define ESP_LOGD(tag, fmt, ...) ((void)(tag))
#define ESP_LOGV(tag, fmt, ...) ((void)(tag))
