ruibartsegura/ESP-Micro_drone/(commit log)

2026-03-26 initial commit - hardware
    [Drone_Frame.FCStd, drone.kicad_pcb, drone.kicad_sch, pcb.FCStd]
2026-03-28 Holes in the pcb
    [drone.kicad_pcb, drone.kicad_sch]
2026-03-28 Pcb with holes
    [Drone_Frame.FCStd, drone.kicad_pcb, drone.kicad_sch, pcb_frame.FCStd, pcb_holder.FCStd, plug_wth_holders.FCStd, smt_wth_holders.FCStd]
2026-03-28 Add project overview and PCB design information
    Added introductory information and PCB design details for the ESP Micro Drone project.
2026-03-28 3d models and images
    [pcb.FCStd, smt_wth_holders.FCStd]
2026-03-28 Rename img/Screenshot from 2026-03-28 18-08-57.png to pcb_smt.png
2026-03-28 Enhance README with images and layout for PCB design
    Added images and table layout for PCB designs.
2026-04-16 Fix 3.3v
    [drone.kicad_pcb, drone.kicad_sch]
2026-04-18 schematics img
    [drone.kicad_sch, plug_wth_holders.FCStd]
2026-05-03 fix pcb plug
    [drone.kicad_pcb, drone.kicad_sch]
2026-05-12 pcb mini
    [drone.kicad_pcb, drone.kicad_sch]
2026-05-12 img mini pcb
2026-06-01 pcb updated
    [Drone_Frame.FCStd, bom.csv, designators.csv, drone.kicad_pcb, drone.kicad_sch, mini_frame.FCStd, mini_frame_motors.FCStd, positions.csv]
2026-07-09 PCB for gy-87
    [bom.csv, designators.csv, drone.kicad_pcb, drone.kicad_sch, positions.csv]
2026-09-11 Change IMU logic, add flight controll add cmd_vel sub
2026-09-25 fixes + start odom
    [attitude_controller.c, motors.c, odometry_estimator.c, ros_coordinator.c]
2026-10-10 Change qos motor_pub
2026-10-12 odometry done
